morgensternR/Fiber_Bundle_Package/Hexapod setup CAD/device-mount-example.png

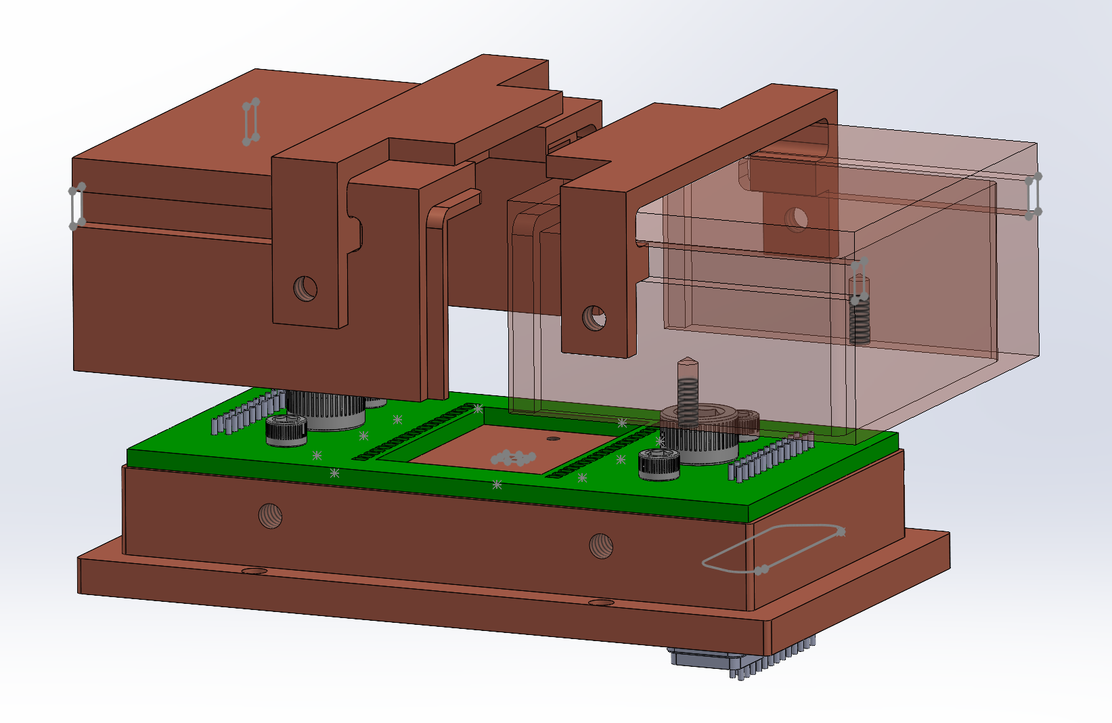
Hexapod setup CAD/device-mount-example.png
