morgensternR/Fiber_Bundle_Package/Notes/Estimate Metal to Air HTC in iso320 Full Nipple (o 10044a089dab46e4a3ba56bcf0c5d133.pdf

Estimate Metal to Air HTC in iso320 Full Nipple (one side open) | 1

# Estimate Metal to Air HTC in iso320 Full Nipple (one side open)

Status | Done
Project | Heat Fiber Bundle Mounting Block (https://www.notion.so/Heat-Fiber-Bundle-Mounting-Block-4a05a1461bce4cf68ee90a54ee6b3974?pvs=21)

Tags

Goal: Estimate Heater Cart Heat transfer coefficient to air in inside non-capped chamber. Use this as a reference to see if we can Heat up mounting block.

EQ: | u = Heat Transfer coefficient ( | ), A = Area ( | ), | = Temperature difference
from environment (T2 - T1) (K)

Experiment Setup:

Surface area of Heater Cartage = = 2pi*(3.175/2 mm) * (25.4 mm) = 253mm^2 = 2.53e-4 m ^2 Initial room Temperature T1 = 26 C = 299.15K

Trial # | T1 Environment Temperature (K) | T2 Heater Cart Temperature (K) | Voltage / Current | Power (W) | u = P / A*dT (W / m^2 K)
Trial 1 | 299.15 | 384.15 | 5.72V / 0.23A | 1.32 | 61.38
P = uAΔT | m²K W m² ΔT

2πrh

Estimate Metal to Air HTC in iso320 Full Nipple (one side open) | 2
Trial 2 | 299.15 | 455.15 | 7.99V / 0.32A | 2.56 | 74.40
Trial 3 | 299.15 | 347.15 | 4V / 0.16A | 0.64 | 52.70

Using HTC Data from Above

Goal: If we heat our current mounting block design to +100C from room temperature, what’s is the power required to achieve this with our estimated heat transfer coefficient to air?

Current Mounting Block surface Area = 0.01243 m^2
T2 = 100C over room temp, 130C = 403.15 K
T1 = Room Temp at 26C = 299.15K
Heater transfer coefficient = (61.38 + 74.40 + 52.70) / 2 = 62.83 W / m^2 K
P = (62.83 | )*(0.01243 | ) * (403.15K - 299.15K)
Result = 81.22 W

Then also taking into account black body radiation from our object into the environment:

, Where A is the surface Area, =5.67e-8 Stefan–Boltzmann constant, = Emissivity (assumed worst case of 1 & 0.5), T = Temperature of object, T_o = Temperature of environment.

P = (0.01243m^2)*(5.67e-8 )*(1)*(403.15^4 - 299.15^4)

Result = 12.97 W

Total Required for our mount just being exposed to air (no other thermal connections) = 94.2W 100W

Our Carts are rated for 25W each. Not enough wattage with current setup/

Solutions

Decrease Mounting Block Surface Area

Increase Heater Cart Wattage

Enclose Heat

m²K

W m²

P = Aσϵ(T

4 − T ) o

4 | σ | m²K⁴ W ϵ

m²K⁴

W

≈
