morgensternR/Fiber_Bundle_Package/CAD/Assem1.SLDASM

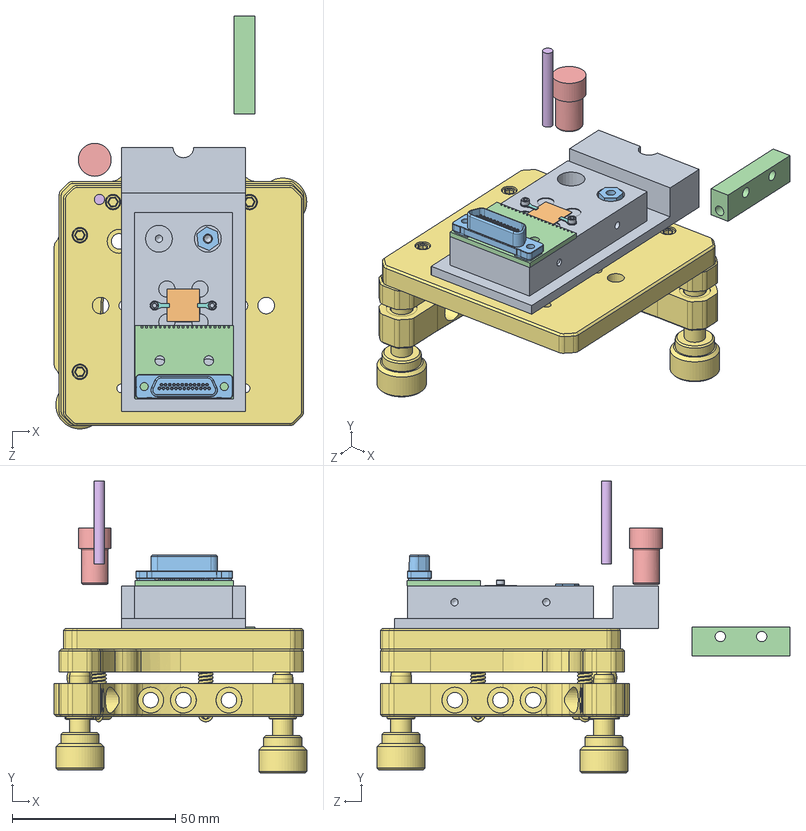
[picture p13: CAD file, 2023-04-29]
CAD/Assem1.SLDASM
77.5 x 89.6 x 126.6 mm
potetntial_mount_design
90349A211_M4_Brass Socket Head Screw x 4
Cartridge_holder_Parallel
centering_peg
heat_cartridge
KM200B-Solidworks_edited
BeCu_Clamp x 2
92196A047_18-8 Stainless Steel Socket Head Screw x 2
example_chip
SOLID.step
micro-d-tes-aaray PCB.step
