morgensternR/Fiber_Bundle_Package/CAD/design03 (heater on side)/Copper_spce_assembly.SLDASM

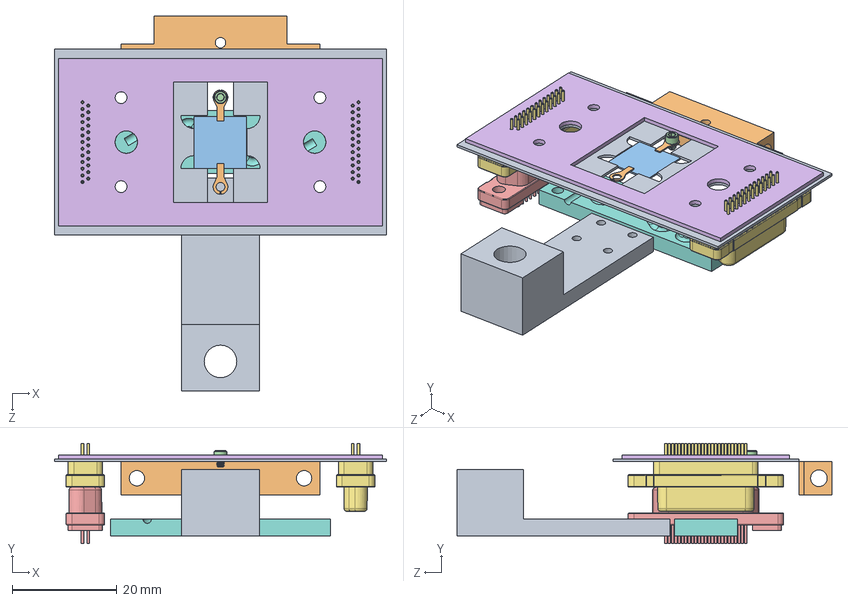
[picture p14: CAD file, 2023-06-28]
CAD/design03 (heater on side)/Copper_spce_assembly.SLDASM
63.5 x 19.2 x 71.7 mm
Sheet_Space
BeCu_Clamp x 2
example_chip
92196A047_18-8 Stainless Steel Socket Head Screw
380-025-213L001.step
Micro_D_TES_Array_Model
380-025-113L001.step x 2
Bottom_Block_off_plate
example_cold_mount
Heater_Cart_02
