morgensternR/Fiber_Bundle_Package/Hexapod setup CAD/COM_assembly.SLDASM

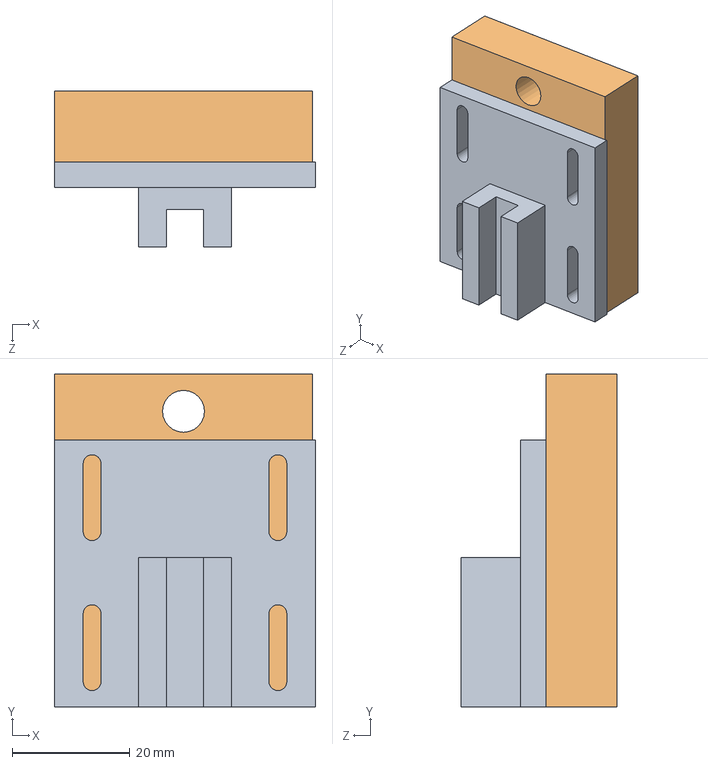
[picture p15: CAD file, 2025-06-10]
Hexapod setup CAD/COM_assembly.SLDASM
44.5 x 56.7 x 26.5 mm
test_spacer
test_fiber_holder
