morgensternR/Fiber_Bundle_Package/CAD/design03 (heater on side)/Assembly.SLDASM

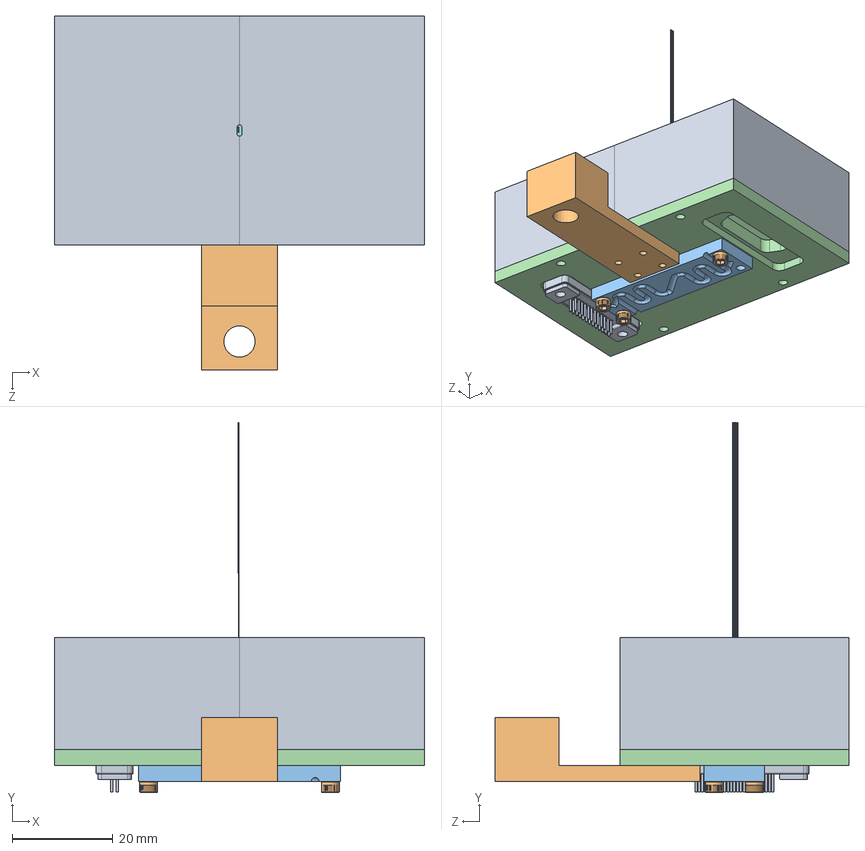
[picture p16: CAD file, 2023-06-09]
CAD/design03 (heater on side)/Assembly.SLDASM
73.5 x 73.5 x 70.3 mm
Box02_Uni x 2
91251A072_2-56_1_8th_Black-Oxide Alloy Steel Socket Head Screw x 7
Bottom_Block_off_plate
Lid
BeCu_Clamp x 2
example_chip
92196A047_18-8 Stainless Steel Socket Head Screw x 2
Fiber_Bundle
380-025-213L001.step
example_cold_mount
