morgensternR/Fiber_Bundle_Package/CAD/Wall02/Wall.STEP

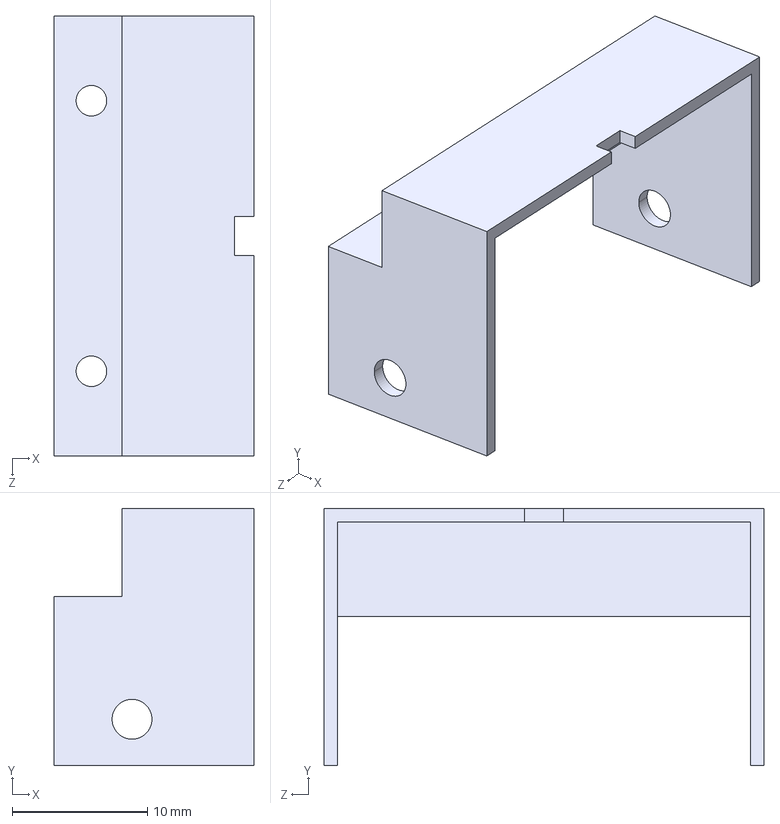
[picture p17: CAD file, 2023-05-13]
CAD/Wall02/Wall.STEP
14.8 x 19.0 x 32.5 mm
