morgensternR/Fiber_Bundle_Package/Hexapod setup CAD/cnc-order-files/device-optical-stage-mount.STEP

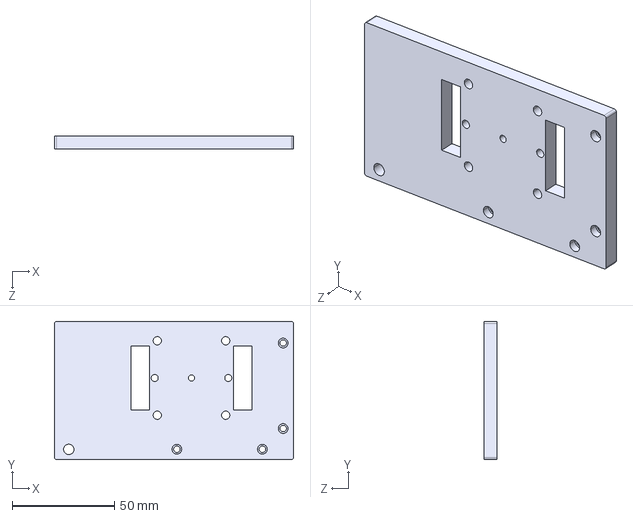
[picture p18: CAD file, 2025-06-20]
Hexapod setup CAD/cnc-order-files/device-optical-stage-mount.STEP
117.2 x 67.8 x 6.35 mm
