morgensternR/Fiber_Bundle_Package/Hexapod setup CAD/parts/device-optical-stage-mount.SLDPRT

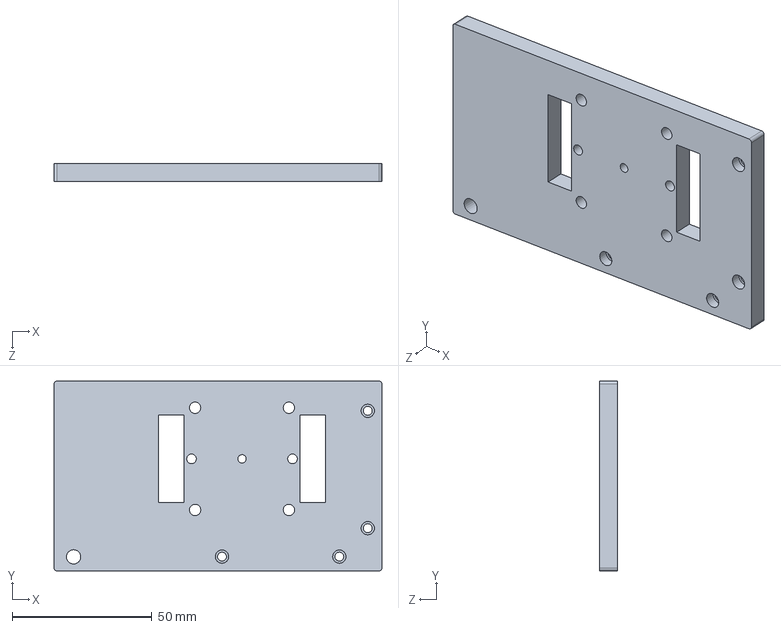
[picture p19: CAD file, 2025-06-20]
Hexapod setup CAD/parts/device-optical-stage-mount.SLDPRT
117.2 x 67.8 x 6.35 mm
