morgensternR/Fiber_Bundle_Package/Hexapod setup CAD/sheetmetal files/device-optical-stage-mount.DXF

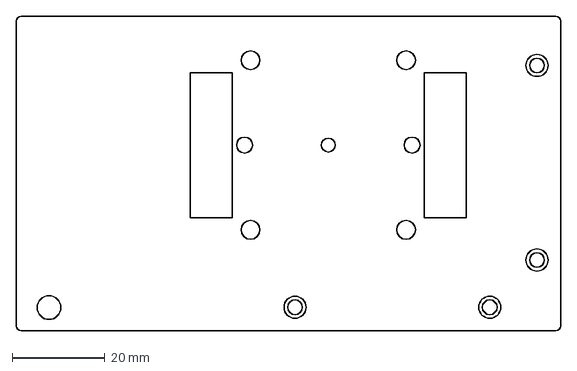
[picture p20: CAD file, 2025-06-20]
Hexapod setup CAD/sheetmetal files/device-optical-stage-mount.DXF
117.2 x 67.8 mm
