morgensternR/Fiber_Bundle_Package/micro-d-tes-aaray - ryan_copy/micro-d-tes-aaray.step

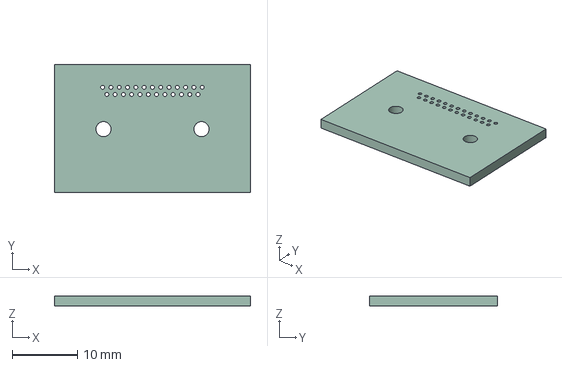
[picture p21: CAD file, 2023-05-02]
micro-d-tes-aaray - ryan_copy/micro-d-tes-aaray.step
30.0 x 19.6 x 1.58 mm
