morgensternR/Fiber_Bundle_Package/PCBs/240311 micro-d-tes-adapter/micro-d-tes-aaray_new_test.step

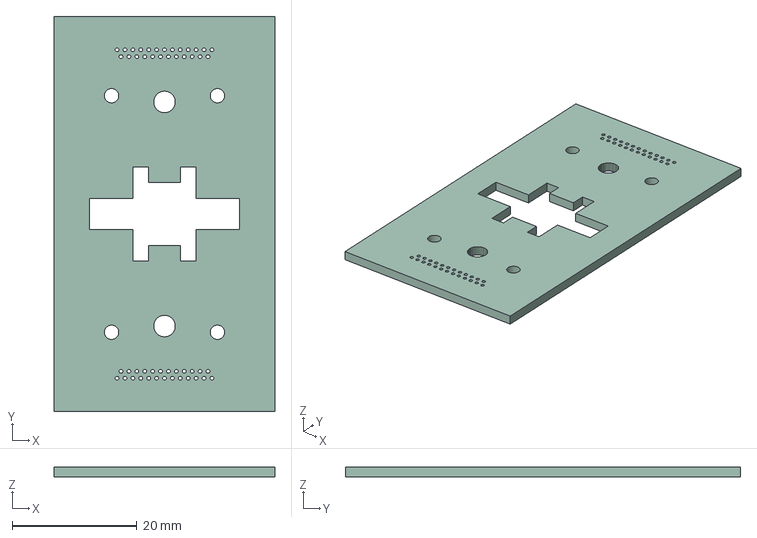
[picture p22: CAD file, 2023-09-30]
PCBs/240311 micro-d-tes-adapter/micro-d-tes-aaray_new_test.step
35.5 x 63.5 x 1.58 mm
