morgensternR/Fiber_Bundle_Package/CAD/micro-d-tes-aaray.step

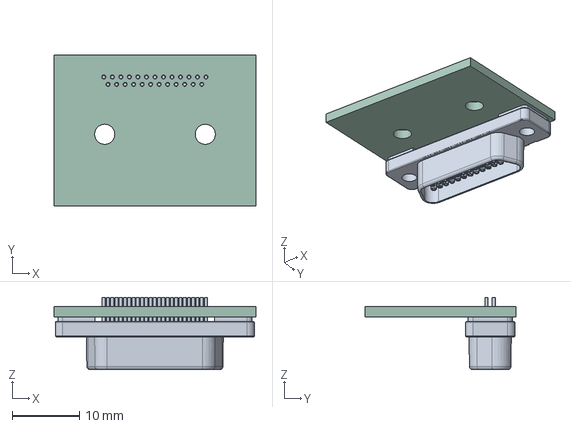
[picture p23: CAD file, 2023-04-29]
CAD/micro-d-tes-aaray.step
30.1 x 22.6 x 10.8 mm
micro-d-tes-aaray PCB
