morgensternR/Fiber_Bundle_Package/Hexapod setup CAD/380-025-213L001.STEP

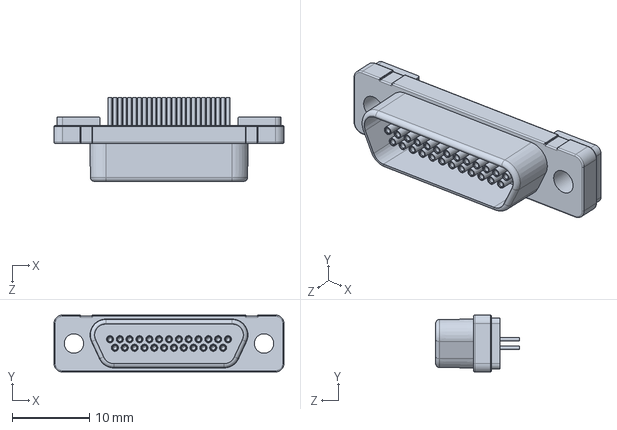
[picture p24: CAD file, 2023-04-27]
Hexapod setup CAD/380-025-213L001.STEP
29.7 x 7.35 x 10.8 mm
