morgensternR/Fiber_Bundle_Package/Hexapod setup CAD/cnc-order-files/device-heater-cart.STEP

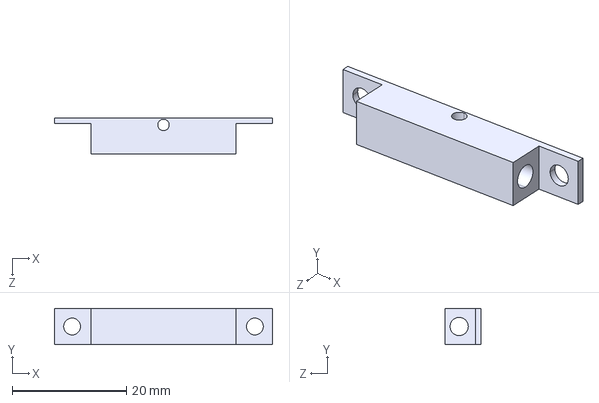
[picture p25: CAD file, 2025-06-20]
Hexapod setup CAD/cnc-order-files/device-heater-cart.STEP
38.1 x 6.35 x 6.35 mm
