morgensternR/Fiber_Bundle_Package/Hexapod setup CAD/parts/device-mount.SLDPRT

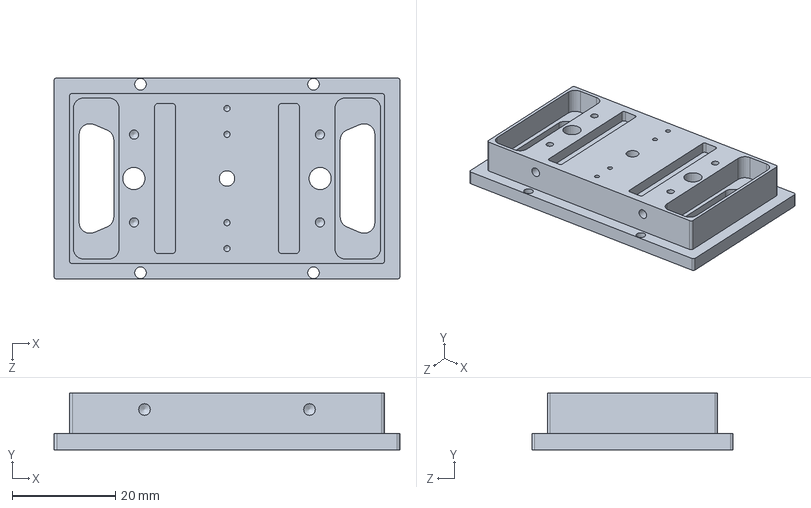
[picture p26: CAD file, 2025-06-19]
Hexapod setup CAD/parts/device-mount.SLDPRT
67.0 x 11.0 x 39.0 mm
