morgensternR/Fiber_Bundle_Package/Hexapod setup CAD/sheetmetal files/Optical_Stage.DXF

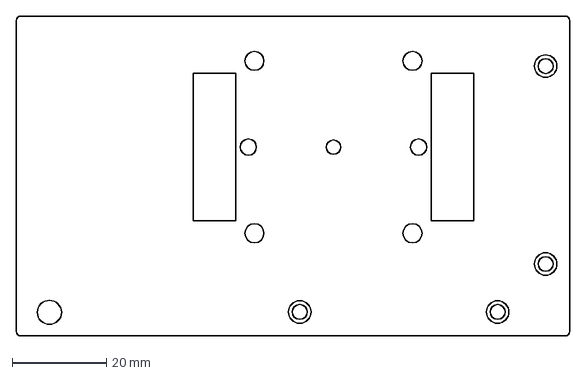
[picture p27: CAD file, 2025-06-19]
Hexapod setup CAD/sheetmetal files/Optical_Stage.DXF
117.2 x 67.8 mm
