morgensternR/Fiber_Bundle_Package/CAD/Cartridge_holder.SLDPRT

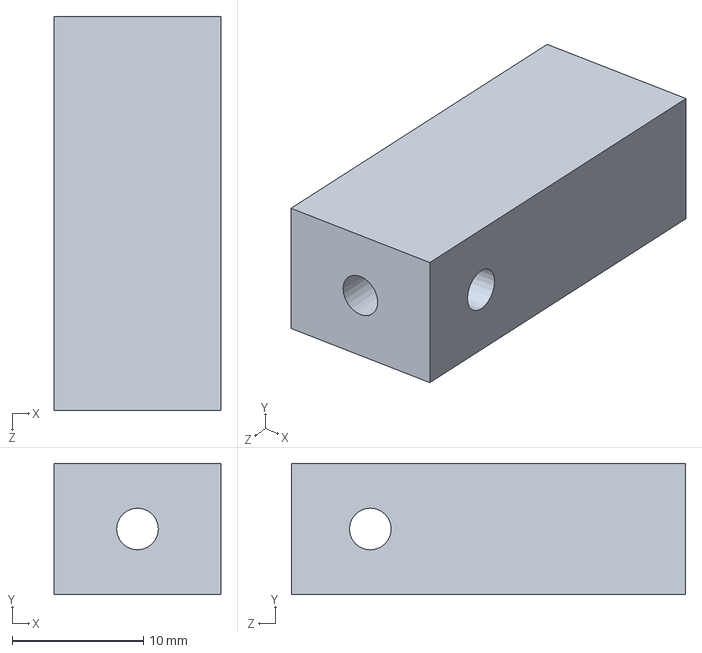
[picture p28: CAD file, 2023-04-27]
CAD/Cartridge_holder.SLDPRT
12.7 x 10.0 x 30.0 mm
