morgensternR/Fiber_Bundle_Package/Hexapod setup CAD/cnc-order-files/device-mount-lid.STEP

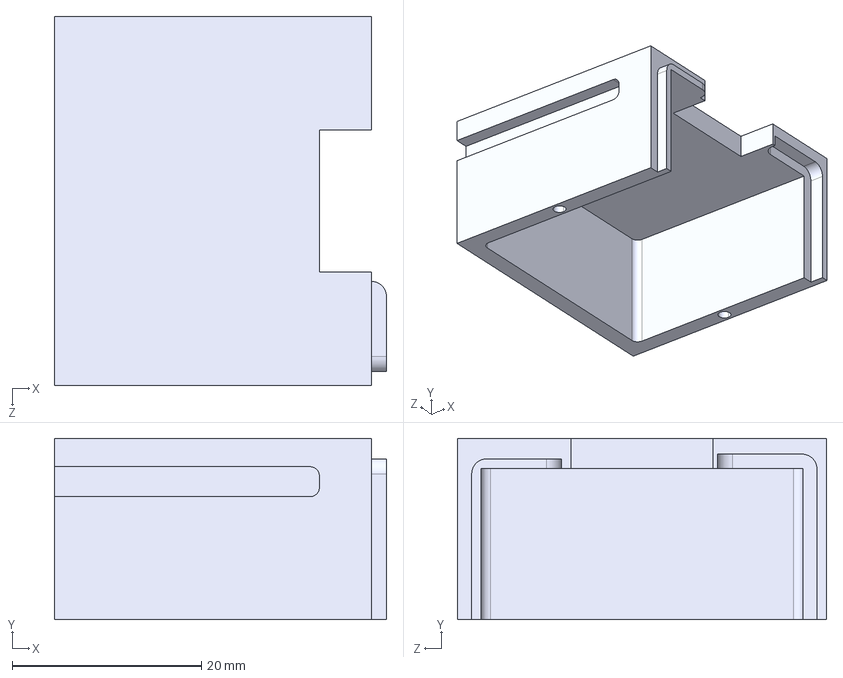
[picture p29: CAD file, 2025-06-19]
Hexapod setup CAD/cnc-order-files/device-mount-lid.STEP
35.1 x 19.2 x 39.0 mm
