morgensternR/Fiber_Bundle_Package/Hexapod setup CAD/parts/brass-fiber-holder.SLDPRT

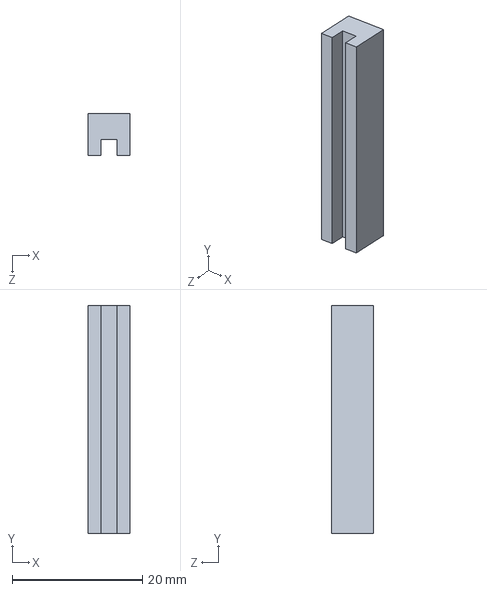
[picture p30: CAD file, 2025-06-19]
Hexapod setup CAD/parts/brass-fiber-holder.SLDPRT
6.50 x 35.0 x 6.50 mm
