morgensternR/Fiber_Bundle_Package/Hexapod setup CAD/sheetmetal files/Flat pattern - right_angle_bracket_0.25al.DXF

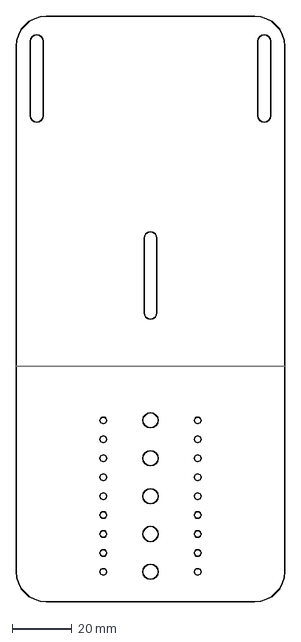
[picture p31: CAD file, 2025-06-10]
Hexapod setup CAD/sheetmetal files/Flat pattern - right_angle_bracket_0.25al.DXF
90.0 x 196.3 mm
