morgensternR/Fiber_Bundle_Package/Hexapod setup CAD/cnc-order-files/device-mount.STEP

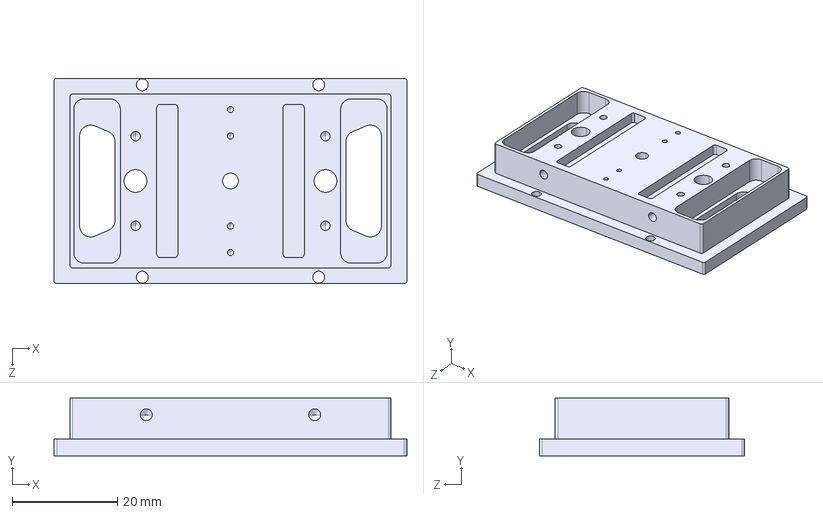
[picture p32: CAD file, 2025-06-19]
Hexapod setup CAD/cnc-order-files/device-mount.STEP
67.0 x 11.0 x 39.0 mm
