morgensternR/Fiber_Bundle_Package/Hexapod setup CAD/parts/box-slide-fiber-fixture-clamp.SLDPRT

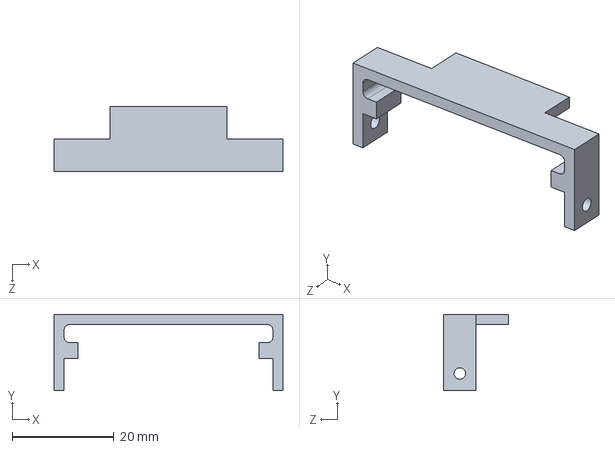
[picture p33: CAD file, 2025-06-19]
Hexapod setup CAD/parts/box-slide-fiber-fixture-clamp.SLDPRT
45.0 x 15.0 x 12.7 mm
