morgensternR/Fiber_Bundle_Package/Hexapod setup CAD/sheetmetal files/Flat pattern - right_angle_bracket.DXF

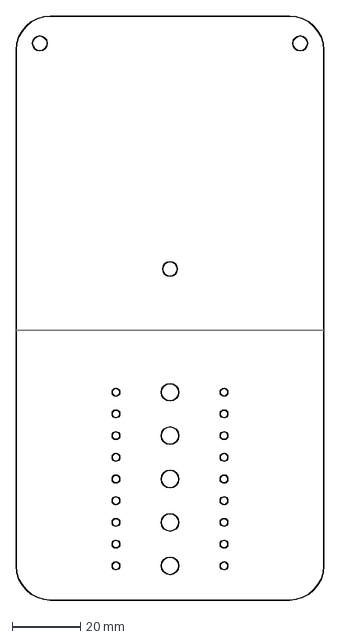
[picture p34: CAD file, 2025-05-05]
Hexapod setup CAD/sheetmetal files/Flat pattern - right_angle_bracket.DXF
90.0 x 170.9 mm
