morgensternR/Fiber_Bundle_Package/CAD/copper_block.SLDPRT

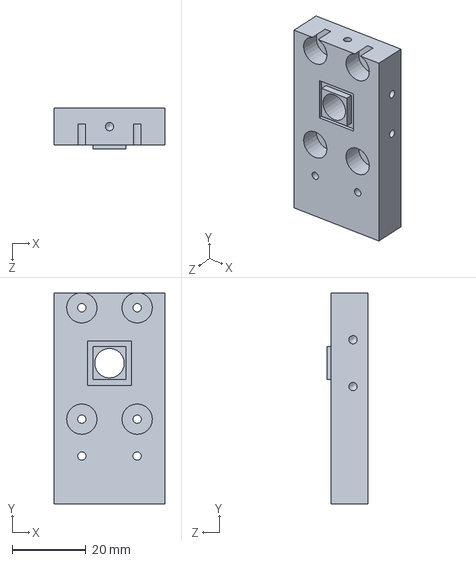
[picture p35: CAD file, 2023-04-27]
CAD/copper_block.SLDPRT
30.0 x 57.2 x 11.0 mm
