morgensternR/Fiber_Bundle_Package/Hexapod setup CAD/parts/device-mount-lid.SLDPRT

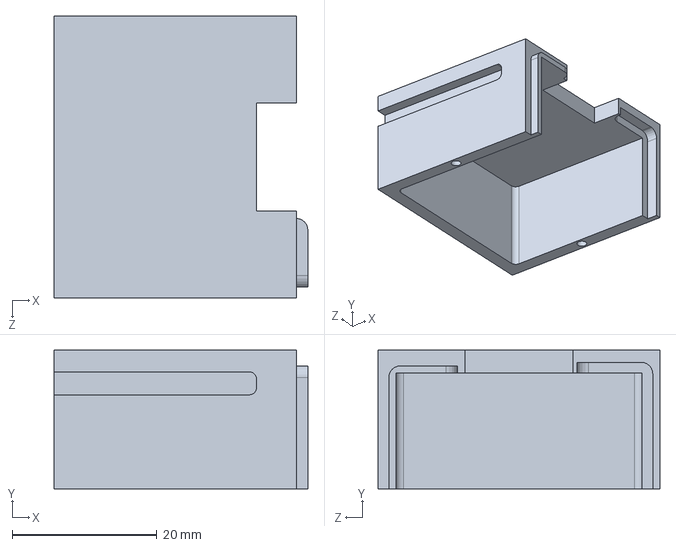
[picture p36: CAD file, 2025-06-19]
Hexapod setup CAD/parts/device-mount-lid.SLDPRT
35.1 x 19.2 x 39.0 mm
