morgensternR/Fiber_Bundle_Package/Hexapod setup CAD/sheetmetal files/hexapod_to_optical_table.DXF

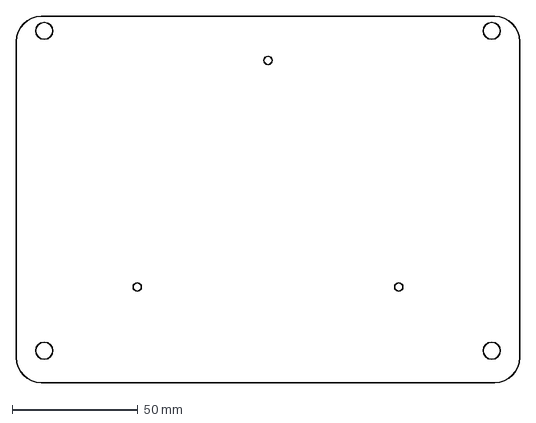
[picture p37: CAD file, 2025-04-04]
Hexapod setup CAD/sheetmetal files/hexapod_to_optical_table.DXF
200.0 x 145.5 mm
