morgensternR/Fiber_Bundle_Package/Hexapod setup CAD/parts/380-025-213L001-microD-25.SLDPRT

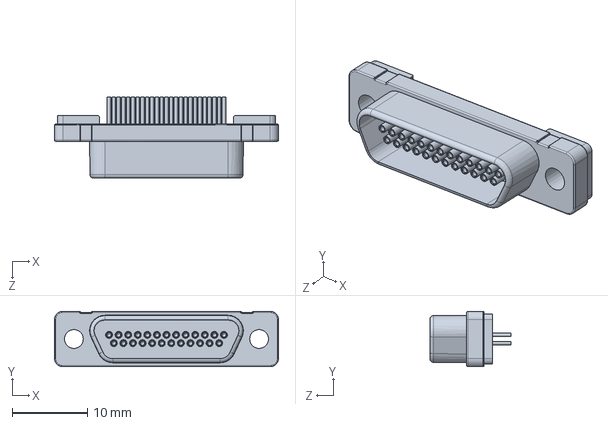
[picture p38: CAD file, 2025-06-19]
Hexapod setup CAD/parts/380-025-213L001-microD-25.SLDPRT
29.7 x 7.35 x 10.8 mm
