morgensternR/Fiber_Bundle_Package/Hexapod setup CAD/parts/right-angle-fiber-to-heaxpod-adapter.SLDPRT

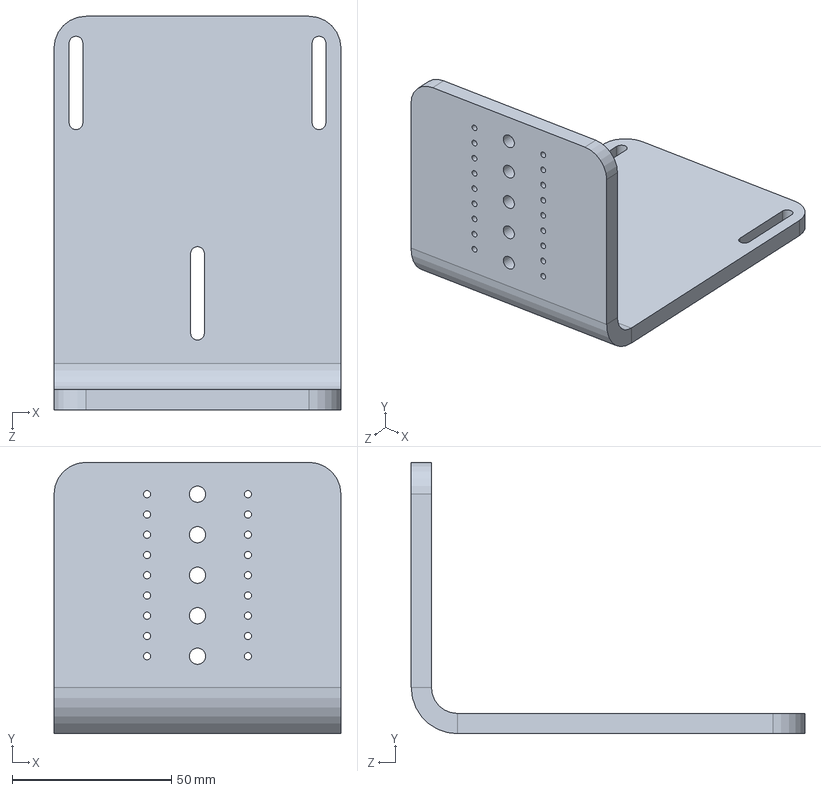
[picture p39: CAD file, 2025-06-10]
Hexapod setup CAD/parts/right-angle-fiber-to-heaxpod-adapter.SLDPRT
90.0 x 85.1 x 123.4 mm
