morgensternR/Fiber_Bundle_Package/CAD/pcb.SLDPRT

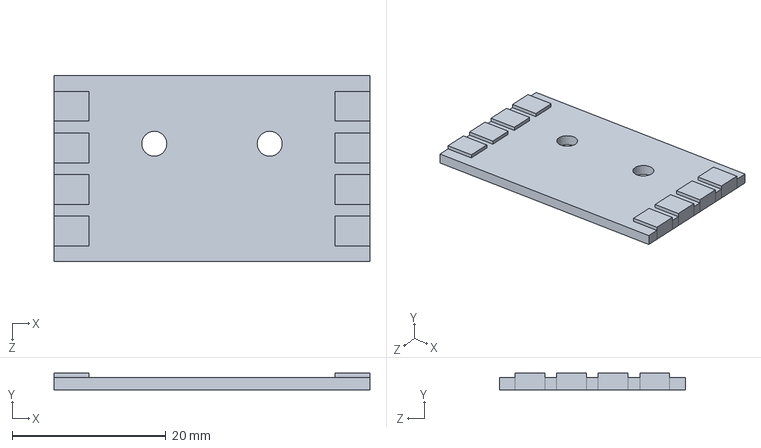
[picture p40: CAD file, 2023-04-27]
CAD/pcb.SLDPRT
41.1 x 2.16 x 24.2 mm
