morgensternR/Fiber_Bundle_Package/Hexapod setup CAD/parts/KM200B-Solidworks_edited.SLDPRT

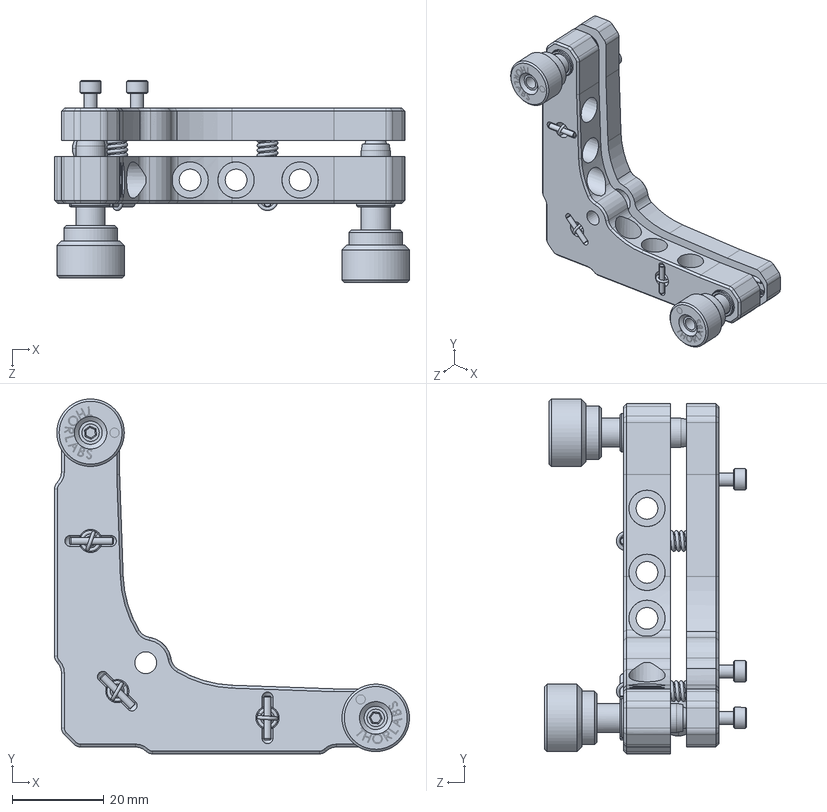
[picture p41: CAD file, 2025-04-04]
Hexapod setup CAD/parts/KM200B-Solidworks_edited.SLDPRT
77.5 x 77.5 x 44.1 mm
