morgensternR/Fiber_Bundle_Package/CAD/Test_fixture.SLDPRT

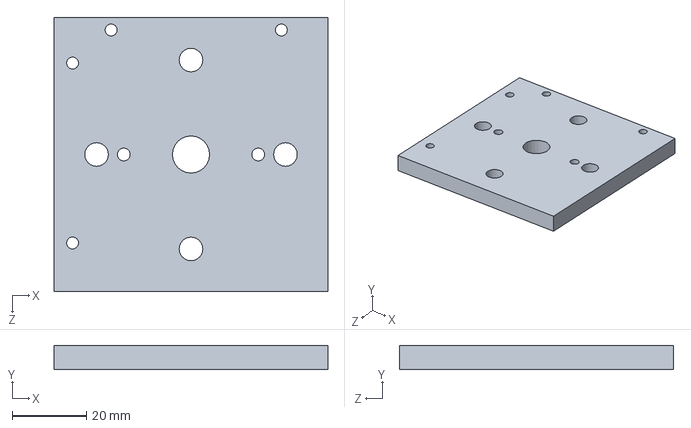
[picture p42: CAD file, 2023-04-27]
CAD/Test_fixture.SLDPRT
73.7 x 6.48 x 73.7 mm
