morgensternR/Fiber_Bundle_Package/Hexapod setup CAD/parts/test_spacer.SLDPRT

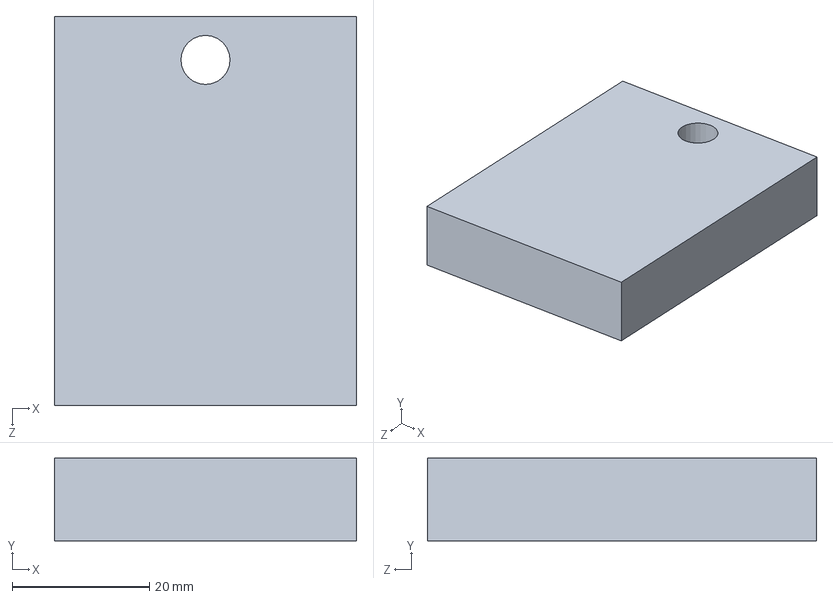
[picture p43: CAD file, 2025-04-04]
Hexapod setup CAD/parts/test_spacer.SLDPRT
43.9 x 12.1 x 56.7 mm
