morgensternR/Fiber_Bundle_Package/Hexapod setup CAD/parts/test_fiber_holder.SLDPRT

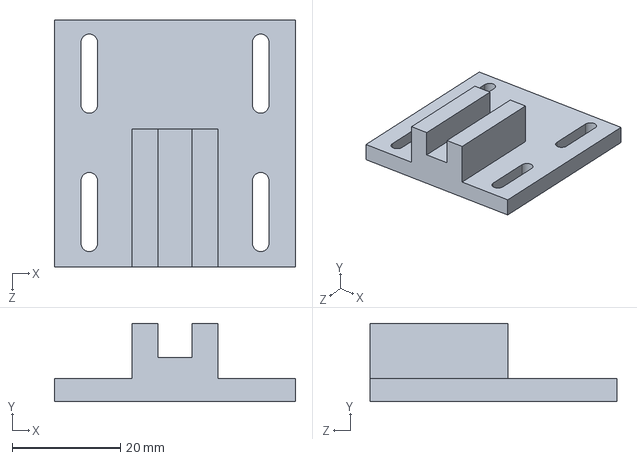
[picture p44: CAD file, 2025-04-04]
Hexapod setup CAD/parts/test_fiber_holder.SLDPRT
44.5 x 14.5 x 45.5 mm
