morgensternR/Fiber_Bundle_Package/Hexapod setup CAD/parts/device-heater-cart.SLDPRT

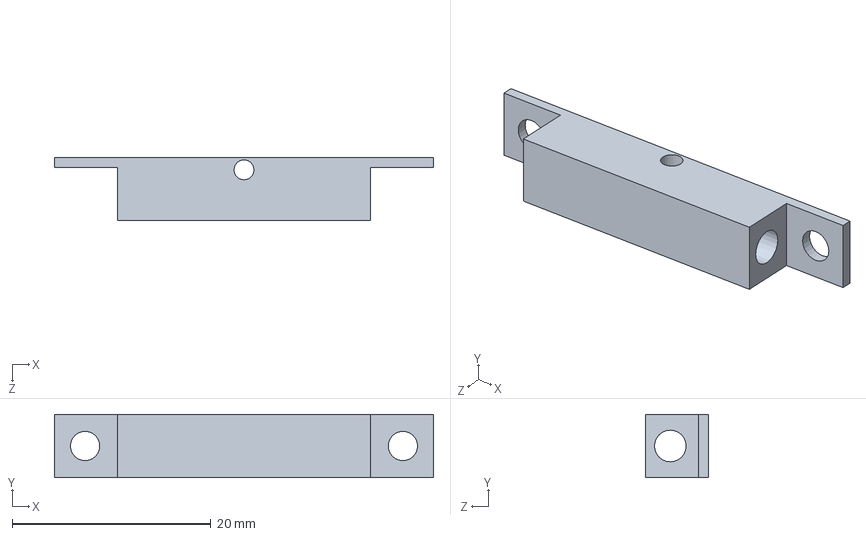
[picture p45: CAD file, 2025-04-04]
Hexapod setup CAD/parts/device-heater-cart.SLDPRT
38.1 x 6.35 x 6.35 mm
