morgensternR/Fiber_Bundle_Package/Hexapod setup CAD/parts/MB1836-Solidworks.sldprt

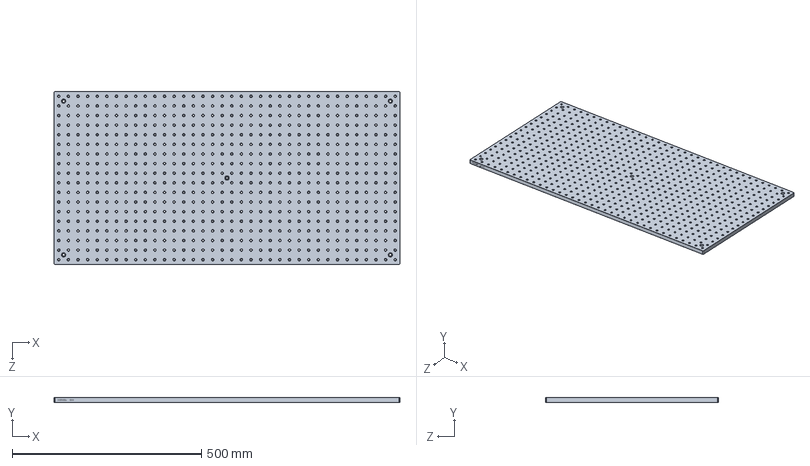
[picture p46: CAD file, 2025-04-04]
Hexapod setup CAD/parts/MB1836-Solidworks.sldprt
914.4 x 12.7 x 457.2 mm
