morgensternR/Fiber_Bundle_Package/Hexapod setup CAD/parts/MB1224-Solidworks.sldprt

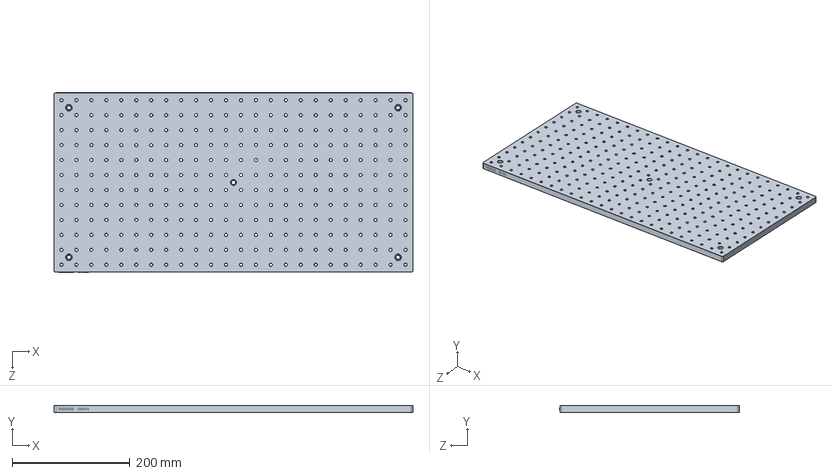
[picture p47: CAD file, 2025-04-04]
Hexapod setup CAD/parts/MB1224-Solidworks.sldprt
609.6 x 12.7 x 304.8 mm
