morgensternR/Fiber_Bundle_Package/Hexapod setup CAD/parts/P8-Solidworks.sldprt

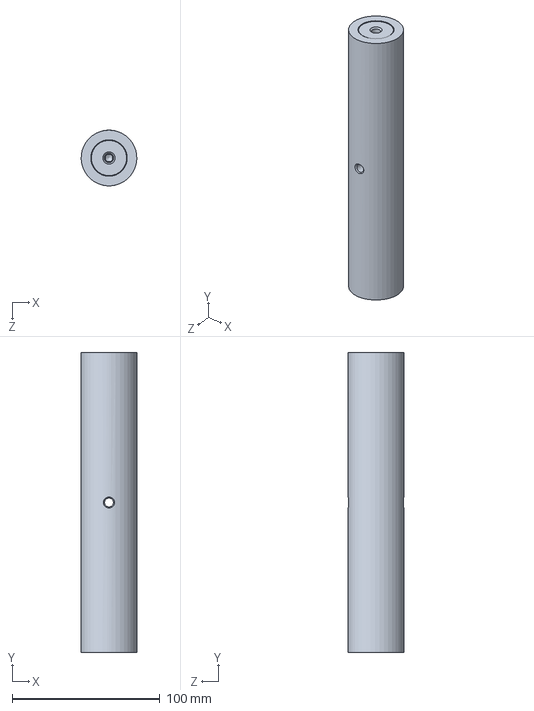
[picture p48: CAD file, 2025-04-04]
Hexapod setup CAD/parts/P8-Solidworks.sldprt
37.7 x 203.2 x 37.7 mm
