morgensternR/Fiber_Bundle_Package/Hexapod setup CAD/parts/hexapod-to-optical-table-adapter.SLDPRT

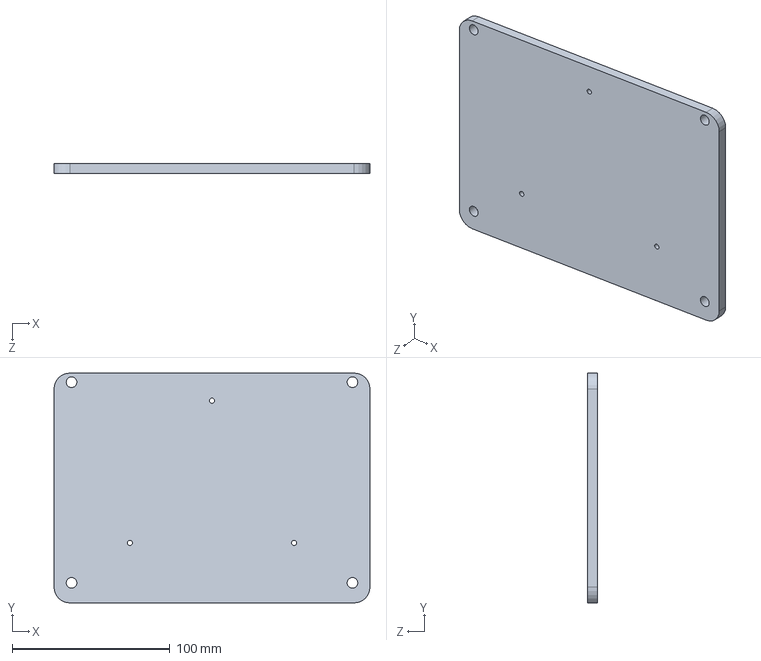
[picture p49: CAD file, 2025-04-04]
Hexapod setup CAD/parts/hexapod-to-optical-table-adapter.SLDPRT
200.0 x 145.5 x 6.35 mm
