morgensternR/Fiber_Bundle_Package/Hexapod setup CAD/parts/BeCu_Clamp.SLDPRT

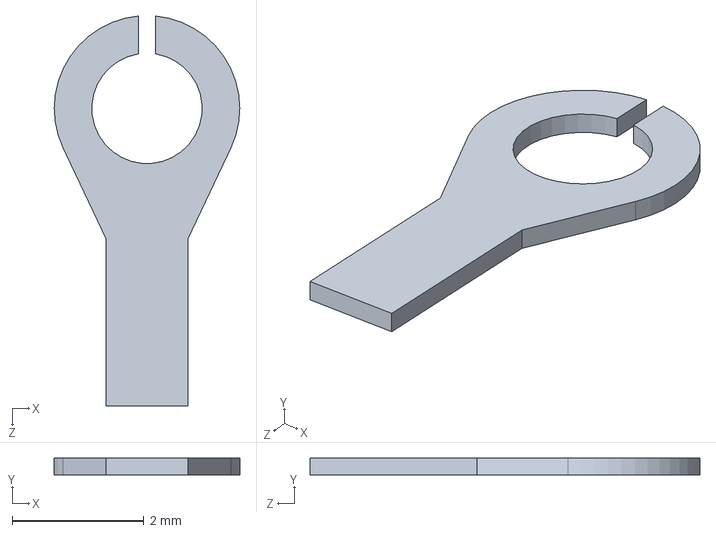
[picture p50: CAD file, 2025-04-04]
Hexapod setup CAD/parts/BeCu_Clamp.SLDPRT
2.82 x 0.254 x 5.93 mm
