morgensternR/Fiber_Bundle_Package/Hexapod setup CAD/parts/fiber-bundle.SLDPRT

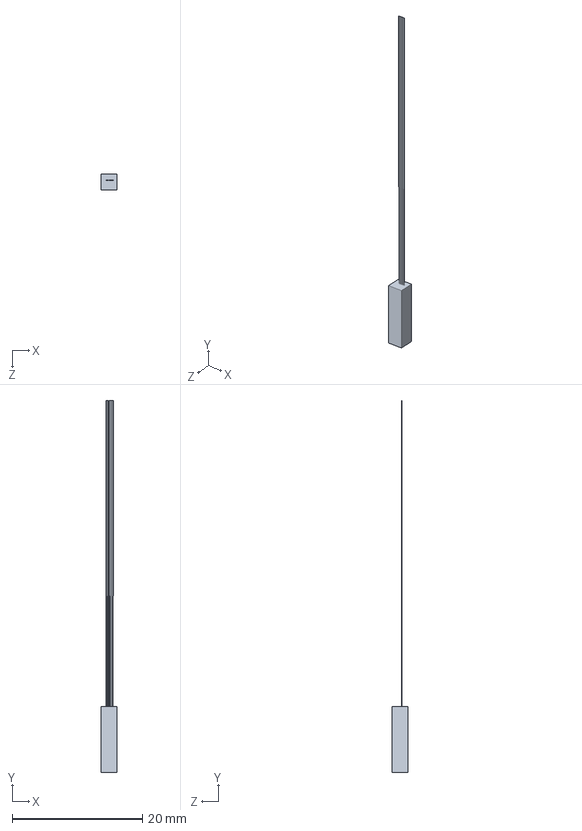
[picture p51: CAD file, 2025-04-04]
Hexapod setup CAD/parts/fiber-bundle.SLDPRT
2.48 x 57.1 x 2.48 mm
