morgensternR/Fiber_Bundle_Package/Hexapod setup CAD/parts/heater-cartridge.SLDPRT

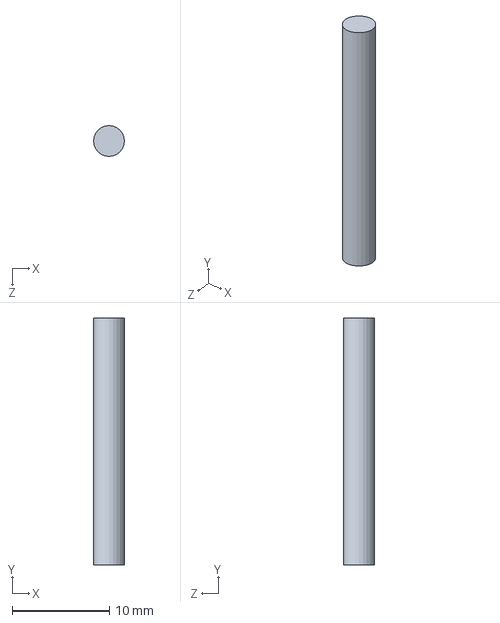
[picture p52: CAD file, 2023-06-09]
Hexapod setup CAD/parts/heater-cartridge.SLDPRT
3.17 x 25.4 x 3.17 mm
