morgensternR/Fiber_Bundle_Package/(list of files, cad)

Other CAD files:
Hexapod setup CAD/cnc-order-files/box-slide-fiber-fixture-clamp.STEP
CAD/91841A009_18-8 Stainless Steel Hex Nut.SLDPRT
CAD/91845A029_18-8 Stainless Steel Hex Nut.SLDPRT
CAD/92196A110_18-8 Stainless Steel Socket Head Screw.SLDPRT
CAD/92196A112_18-8 Stainless Steel Socket Head Screw.SLDPRT
CAD/92196A539_18-8 Stainless Steel Socket Head Screw.SLDPRT
CAD/Wall02/Wall.SLDPRT
Hexapod setup CAD/cnc-order-files/device-optical-stage-mount.SLDPRT
Hexapod setup CAD/cnc-order-files/solidworks-drawing-files/box-slide-fiber-fixture-clamp.SLDDRW
Hexapod setup CAD/cnc-order-files/solidworks-drawing-files/device-mount-lid.SLDDRW
Hexapod setup CAD/cnc-order-files/solidworks-drawing-files/device-mount.SLDDRW
Hexapod setup CAD/cnc-order-files/solidworks-drawing-files/device-optical-stage-mount.SLDDRW
Hexapod setup CAD/parts/91251A072_2-56_1_8th_Black-Oxide Alloy Steel Socket Head Screw.SLDPRT
Hexapod setup CAD/parts/91251A196_8-32, (0.625 len) Socket Head Screw.SLDPRT
Hexapod setup CAD/parts/93785A400_High-Temperature PEEK Plastic Washer.SLDPRT
