morgensternR/Fiber_Bundle_Package/Notes/Heater Block Test 5296fbe1502944f391a5a91d220beff3.pdf

# Heater Block Test

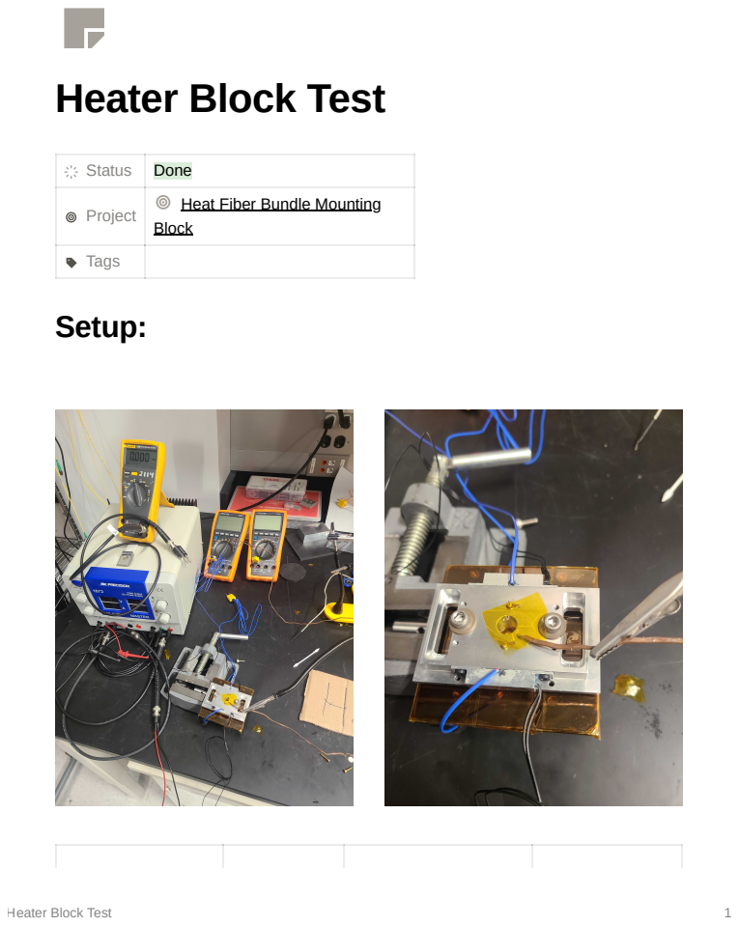
[picture p53: page 1]
Heater Block Test; Setup:

Status | Done
Project | Heat Fiber Bundle Mounting Block (https://www.notion.so/Heat-Fiber-Bundle-Mounting-Block-4a05a1461bce4cf68ee90a54ee6b3974?pvs=21)

Tags

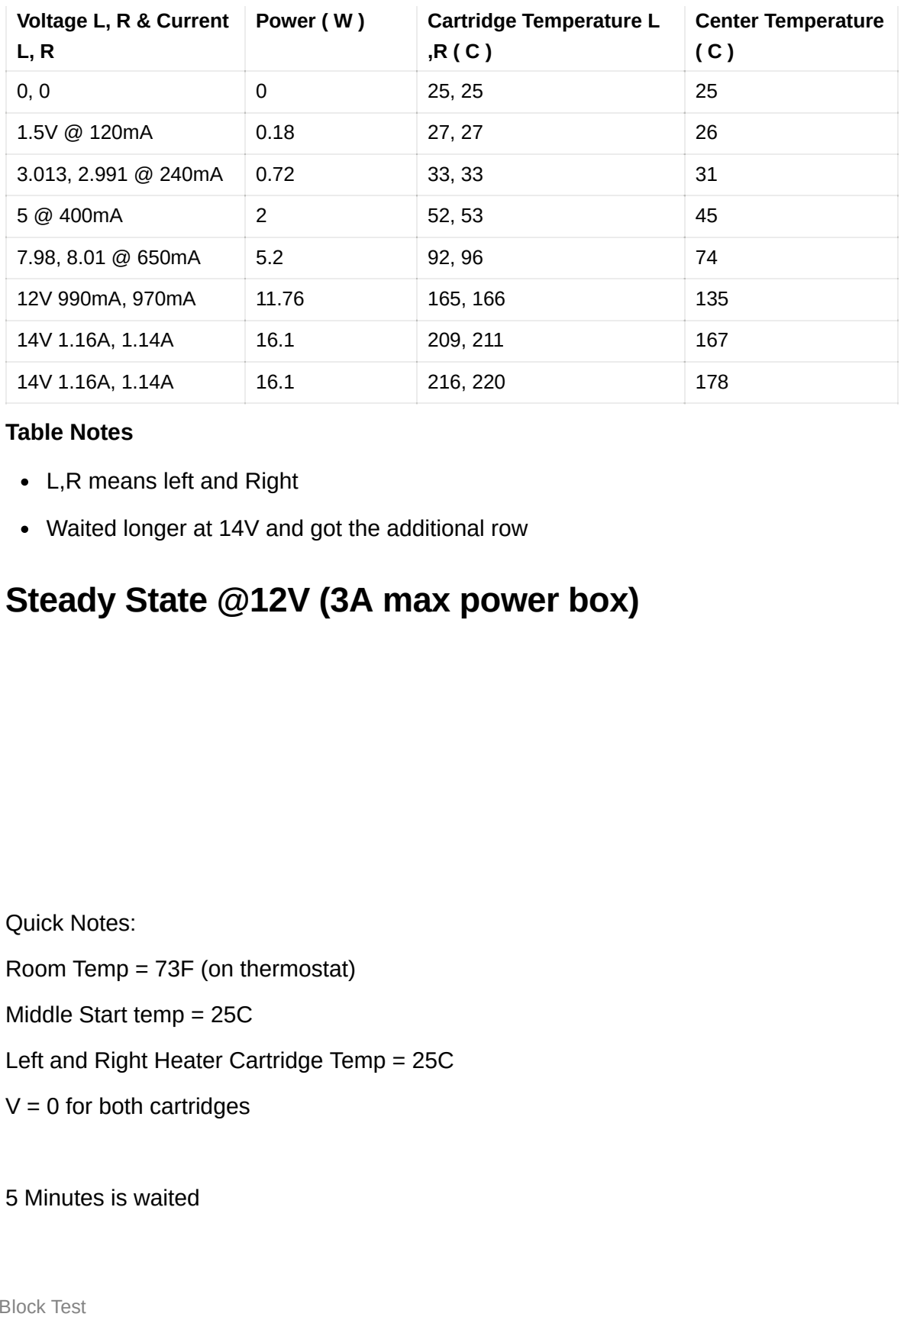
[picture p54: figure]
Voltage L, R & Current L, R; Power ( W ); Cartridge Temperature L; Center Temperature ( C ); Table Notes; L,R means left and Right; Steady State @12V (3A max power box); Quick Notes:; Room Temp = 73F (on thermostat); Middle Start temp = 25C; V = 0 for both cartridges; 5 Minutes is waited

Waited longer at 14V and got the additional row

Left and Right Heater Cartridge Temp = 25C

1.5V set to both Heater Cartridges @ 120mA

Both Carts are at 27C

Center is at 26C

Left is at 3.013V, Right id at 2.991V @ 240mA = 2W

Right is at 33C

Left is at 33C

Middle is at 31C

Both are at 5V @400mA

Left is at 52C, Right is at 53C

Center is at 45C

Left is at 7.98V, right is at 8.01V @ 650mA = 5.2W

Left is at 92C, Right id at 96C Middle is at 74C

Both at 12 V LEft is at 990mA, right is at 970mA

Right is at 165C

Left is at 166C

Middle is at 135C

Botha t 14V, left is at 1.16A, right is at 1.14A

209C left, 211C Right, Middle 167C

waited more time→ left is at 216C, right is at 220C middle is at 178C
