morgensternR/Fiber_Bundle_Package/Hexapod setup CAD/cnc-order-files/box-slide-fiber-fixture-clamp.pdf

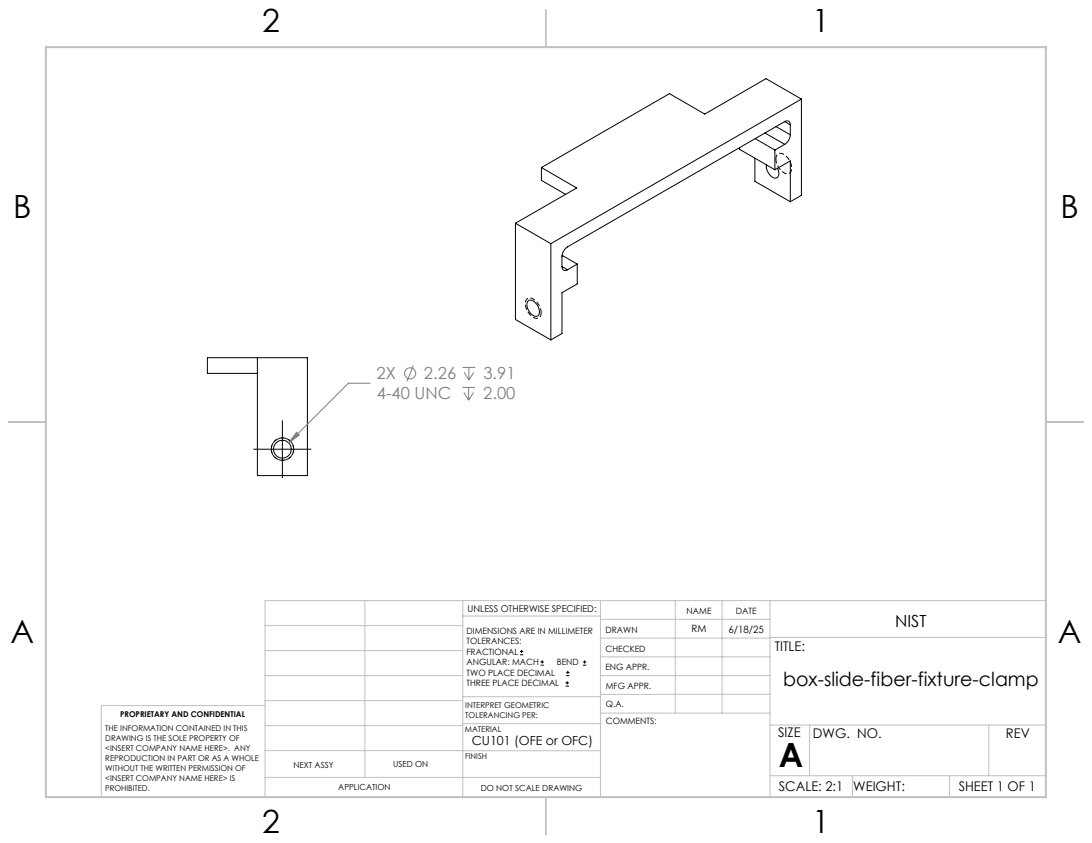
[picture p58: page 1]
4-40 UNC

UNLESS OTHERWISE SPECIFIED: | | NAME | DATE | NIST
DIMENSIONS ARE IN MILLIMETER TOLERANCES: FRACTIONAL ANGULAR: MACH BEND TWO PLACE DECIMAL THREE PLACE DECIMAL | DRAWN | RM | 6/18/25

CHECKED | | | TITLE: box-slide-fiber-fixture-clamp

ENG APPR.
MFG APPR.

INTERPRET GEOMETRIC TOLERANCING PER: | Q.A.
MATERIAL CU101 (OFE or OFC) | | SIZE A | DWG. NO. | REV

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

NEXT ASSY | USED ON | FINISH

APPLICATION | DO NOT SCALE DRAWING | | SCALE: 2:1 | WEIGHT: | SHEET 1 OF 1
