morgensternR/Fiber_Bundle_Package/sleigh/gerbers/sleigh03/output.pdf

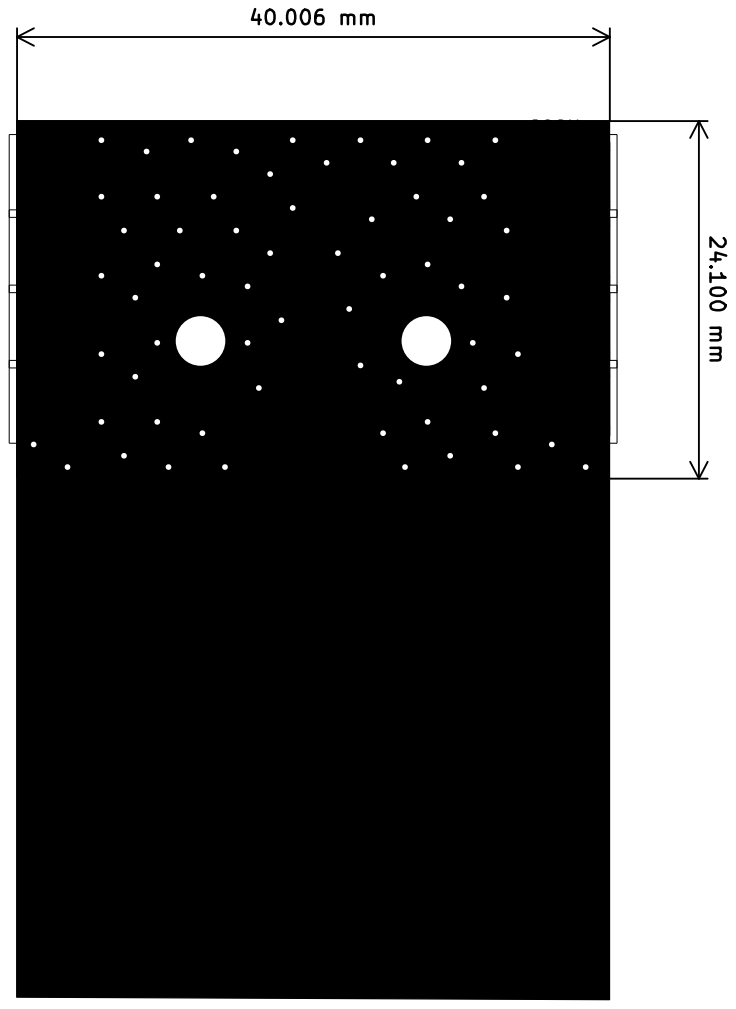
[picture p59: page 1]
