morgensternR/Fiber_Bundle_Package/sleigh/gerbers/sleigh03/sleigh-B_Cu.pdf

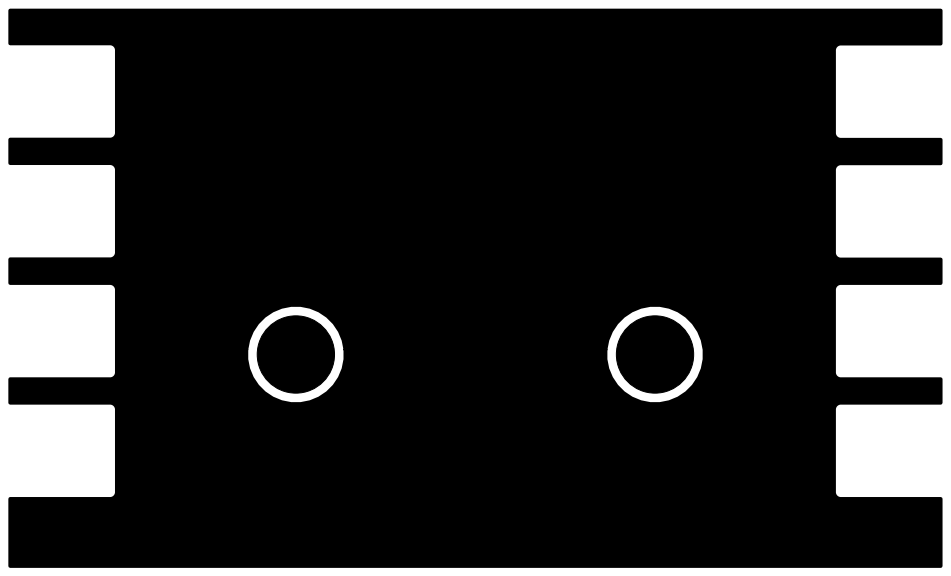
[picture p60: page 1]
