morgensternR/Fiber_Bundle_Package/sleigh/gerbers/sleigh03/sleigh-B_Mask.pdf

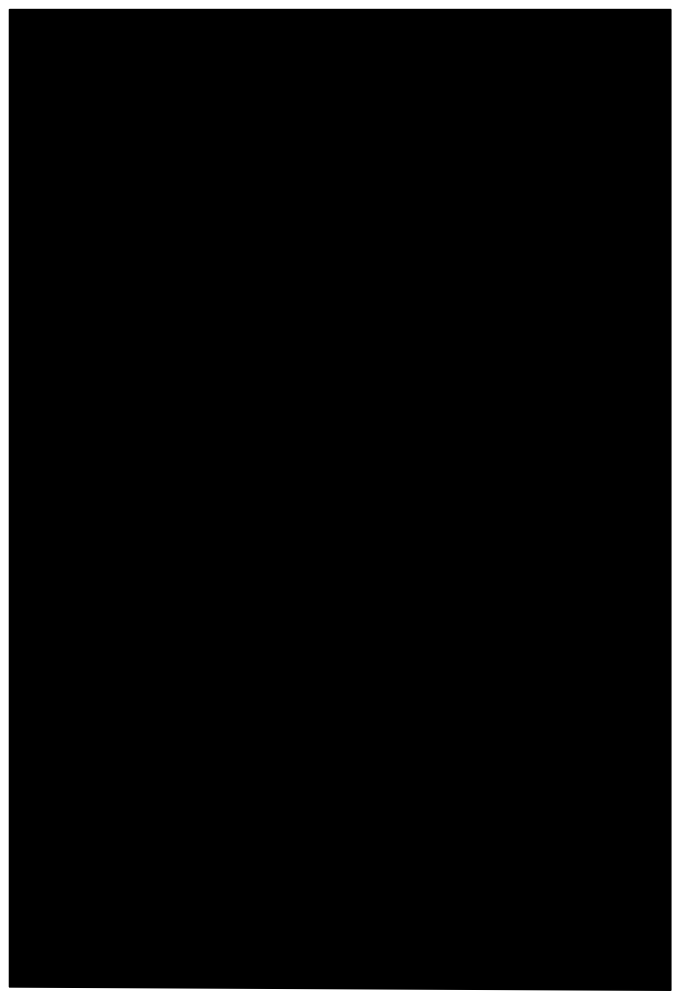
[picture p61: page 1]
