morgensternR/Fiber_Bundle_Package/sleigh/gerbers/sleigh03/sleigh-Edge_Cuts.pdf

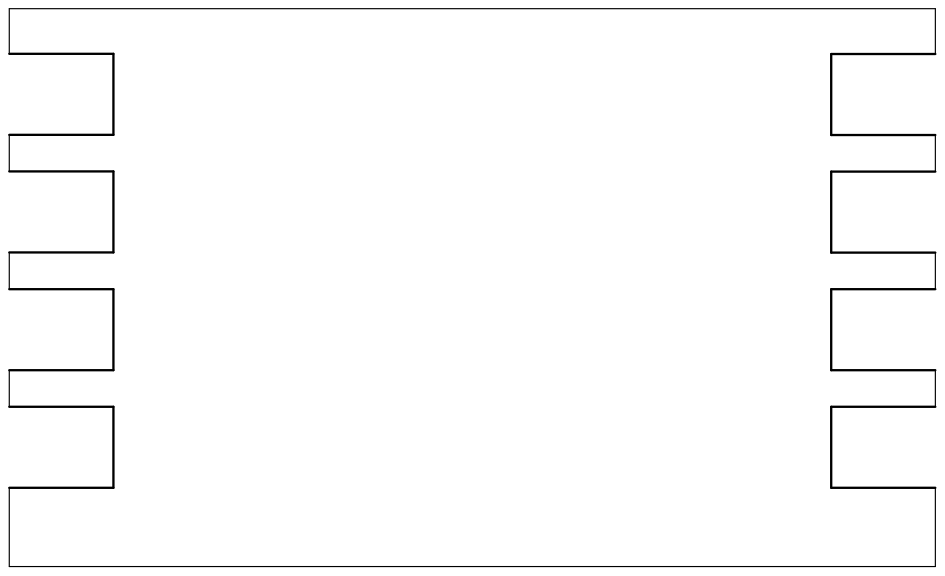
[picture p62: page 1]
