morgensternR/Fiber_Bundle_Package/sleigh/gerbers/sleigh03/sleigh-F_Cu.pdf

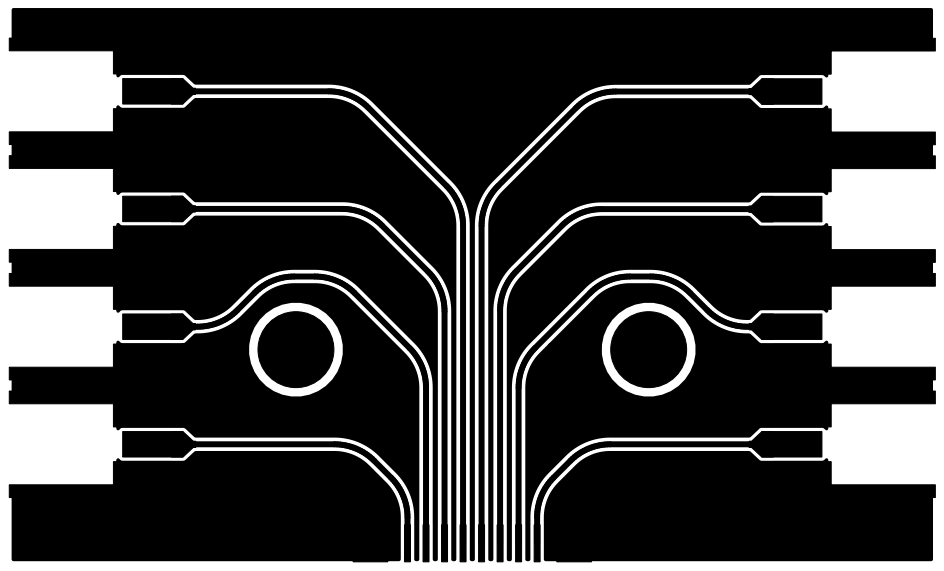
[picture p63: page 1]
