morgensternR/Fiber_Bundle_Package/sleigh/gerbers/sleigh03/sleigh-F_Mask.pdf

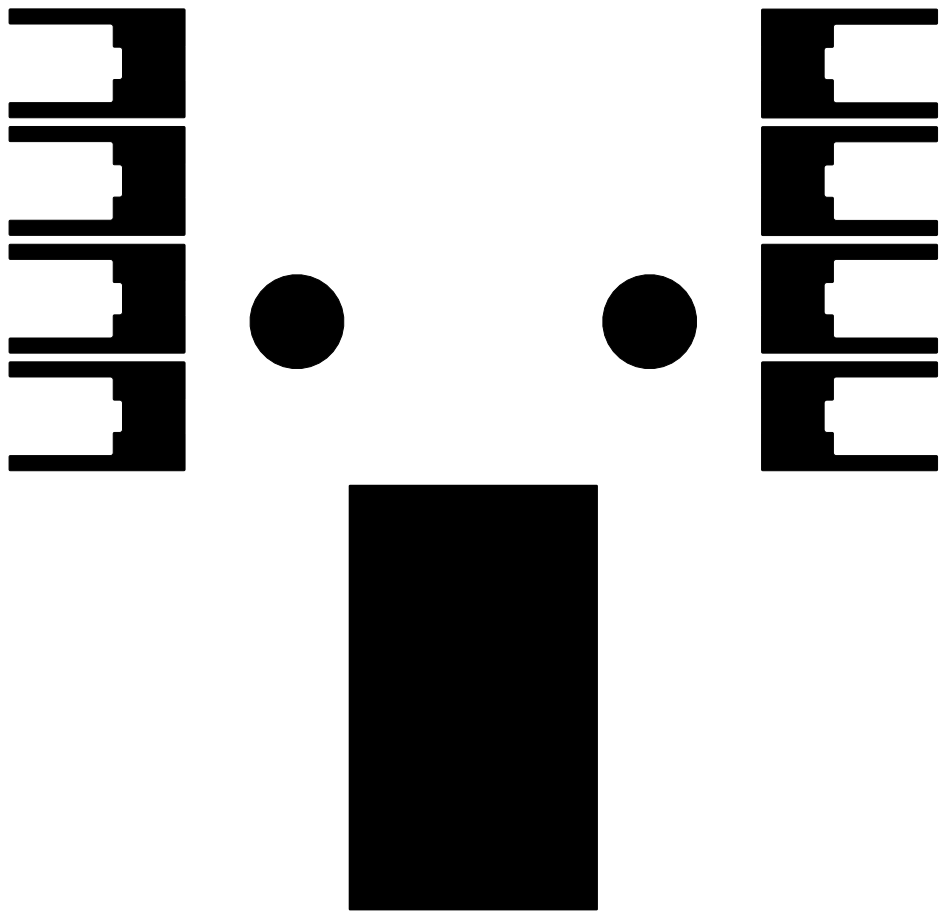
[picture p64: page 1]
