morgensternR/Fiber_Bundle_Package/sleigh/gerbers/sleigh03/sleigh-F_Paste.pdf

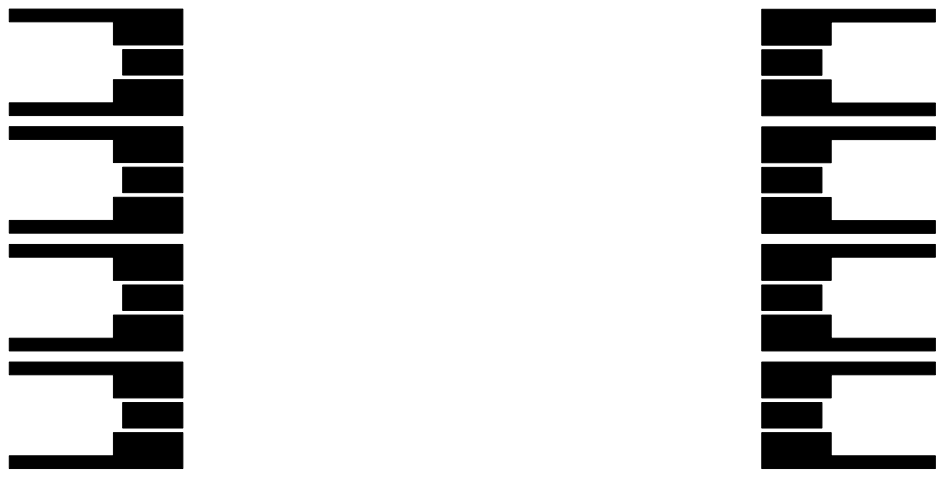
[picture p65: page 1]
