morgensternR/Fiber_Bundle_Package/sleigh/gerbers/sleigh03/sleigh-F_SilkS.pdf

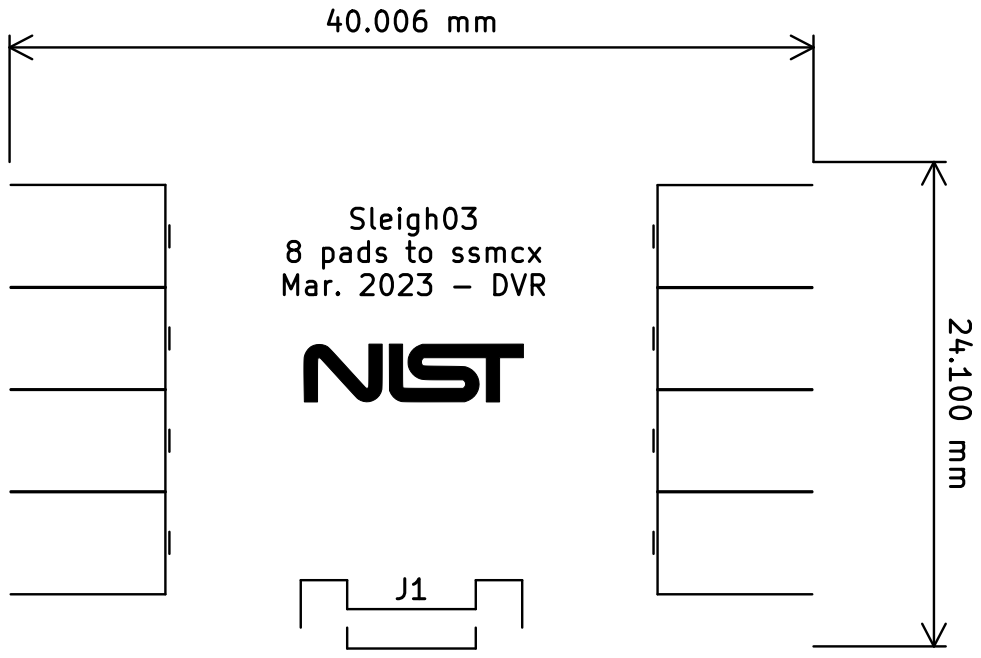
[picture p66: page 1]

Sleigh03
8 pads to ssmcx Mar. 2023 - DVR
