morgensternR/Fiber_Bundle_Package/(list of files, drawings)

Other design files:
PCBs/240311 micro-d-tes-adapter/freerouting.dsn
PCBs/240311 micro-d-tes-adapter/temp-freerouting.dsn
PCBs/micro-d-tes-aaray/freerouting.dsn
PCBs/micro-d-tes-aaray/temp-freerouting.dsn
