morgensternR/Fiber_Bundle_Package/PCBs/240311 micro-d-tes-adapter/micro-d-tes-aaray.kicad_pcb

## KiCad design PCBs/240311 micro-d-tes-adapter/micro-d-tes-aaray.kicad_pcb (2024-03-11)

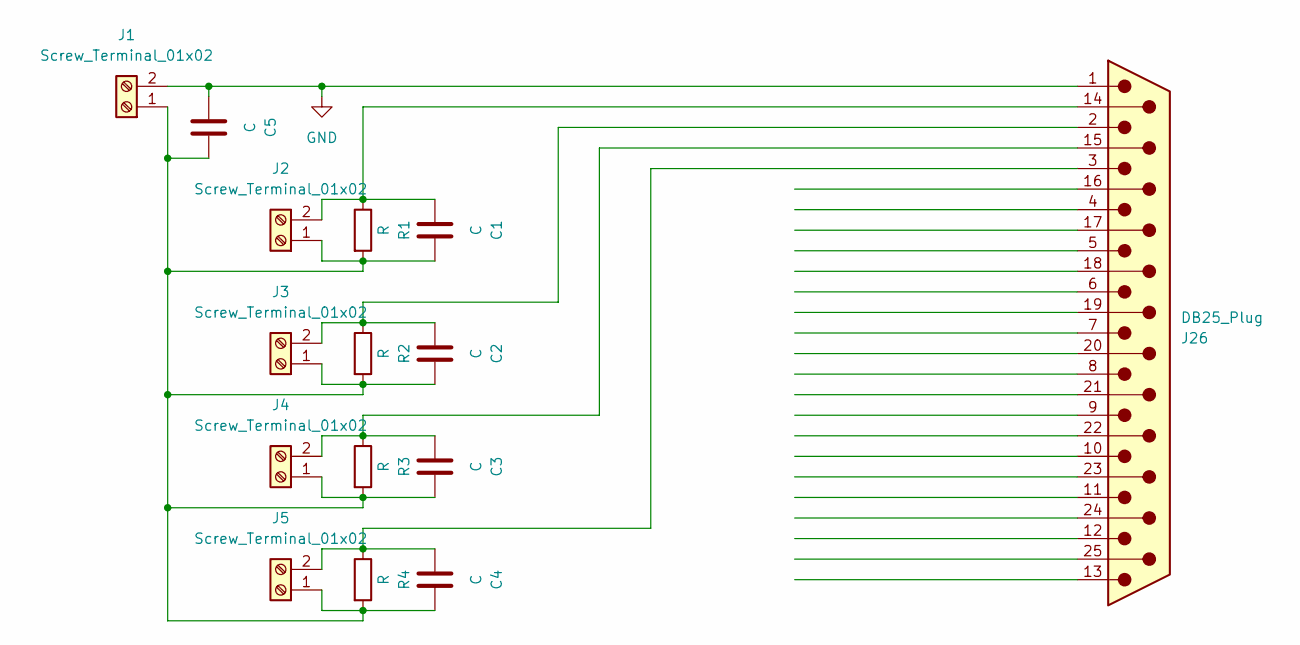
[picture p67: schematic micro-d-tes-aaray.kicad_sch]

Parts:
C1, C2, C3, C4, C5: C; C_0805_2012Metric; LCSC C82028
J1, J2, J3, J4, J5: Screw_Terminal_01x02; TerminalBlock_Phoenix_MKDS-1,5-2-5.08_1x02_P5.08mm_Horizont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; LCSC C8465
J26: DB25_Plug; Norcomp-380-025-113L001-microd_Updated
R1, R2, R3, R4: R; R_0805_2012Metric; LCSC C149504

Connections:
GND: C5.1, J1.2, J26.1
unnamed: C1.2, C2.2, C3.2, C4.2, C5.2, J1.1, J2.1, J3.1, J4.1, J5.1, R1.2, R2.2, R3.2, R4.2
unnamed: C1.1, J2.2, J26.14, R1.1
unnamed: C2.1, J3.2, J26.2, R2.1
unnamed: C4.1, J5.2, J26.3, R4.1
unnamed: C3.1, J4.2, J26.15, R3.1

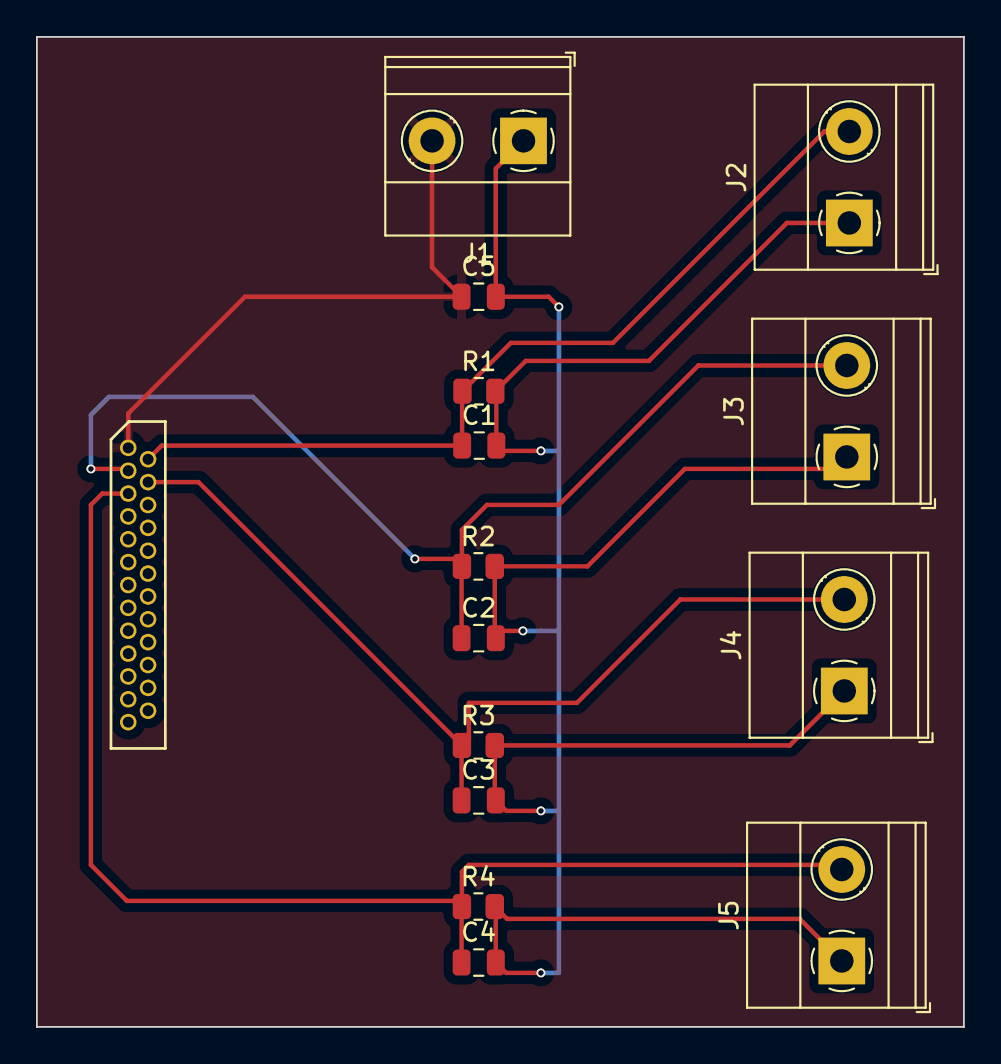
[picture p68: board micro-d-tes-aaray.kicad_pcb from above]

Board: 2 copper layers, 51.5 x 55.0 mm, 15 parts (1 on the bottom side), 6 nets.
