morgensternR/Fiber_Bundle_Package/(commit log)

2023-04-27 repalced with old_
    [91841A009_18-8 Stainless Steel Hex Nut.SLDPRT, 91845A029_18-8 Stainless Steel Hex Nut.SLDPRT, 92196A110_18-8 Stainless Steel Socket Head Screw.SLDPRT, 92196A112_18-8 Stainless Steel Socket Head Screw.SLDPRT, 92196A539_18-8 Stainless Steel Socket Head Screw.SLDPRT, Assem1.SLDASM, Cartridge_holder.SLDPRT, Cartridge_holder_Parallel.SLDPRT]
2023-04-27 init push
    [micro-d-tes-aaray.kicad_pcb, micro-d-tes-aaray.kicad_sch]
2023-04-28 CAD
    made becu clamps
    made fiber bundle
    made potential new mount design
    [92196A047_18-8 Stainless Steel Socket Head Screw.SLDPRT, Assem1.SLDASM, BeCu_Clamp.SLDPRT, Fiber_Bundle.SLDPRT, potetntial_mount_design.SLDPRT]
2023-04-29 updated Cad
    [90349A211_M4_Brass Socket Head Screw.SLDPRT, Assem.SLDASM, Assem1.SLDASM, BeCu_Clamp.SLDPRT, Cartridge_holder_Parallel.SLDPRT, KM200B-Solidworks_edited.SLDPRT, Shield.SLDPRT, centering_peg.SLDPRT]
2023-05-13 Update
    finished old cad design
    made new cad design
    maybe finalized PCB layout
    [380-025-213L001.step.SLDPRT, BeCu_Clamp.SLDPRT, Board_Geoms.step.SLDASM, Bot.step.SLDASM, Bottom_Block_off_plate.SLDPRT, Box.SLDPRT, Box.STEP, Cartridge_holder_Parallel.SLDDRW]
2023-05-24 added simulation
    [Bottom_Block_off_plate.SLDPRT, Bottom_Block_off_plate.STEP, Heater_Cart_02.SLDPRT]
2023-05-25 update + simulations
    [Heater_Cart_02.SLDPRT, Heater_cart.SLDPRT, heat_cartridge.SLDPRT, micro-d-tes-aaray.kicad_pcb, micro-d-tes-aaray.kicad_sch]
2023-09-30 update pcb
    [031-10-RFXG1.step, Assem1.SLDASM, BNC_Holder.DXF, BNC_Holder.SLDPRT, BNC_Holder.STL, BOM-micro-d-tes-aaray.csv, Sensor_switcher.kicad_pcb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]
2023-10-25 fixed 8-32s
    [micro-d-tes-aaray.kicad_pcb]
2024-03-11 Add micro-d-tes-adapter
    [BOM-micro-d-tes-aaray.csv, freerouting.dsn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]
2025-06-20 added opticla stage to cnc if wanting to order
    [device-optical-stage-mount.DXF, device-optical-stage-mount.SLDDRW, device-optical-stage-mount.SLDPRT, device-optical-stage-mount.STEP]
